86kkd/millionBoard/docs/guide/hardware/Longboard - rev - 07 - 04.JPG

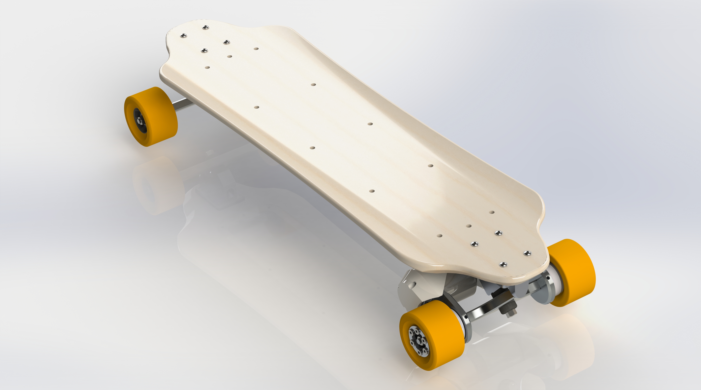
docs/guide/hardware/Longboard - rev - 07 - 04.JPG
