86kkd/millionBoard/docs/guide/hardware/第一版3.png

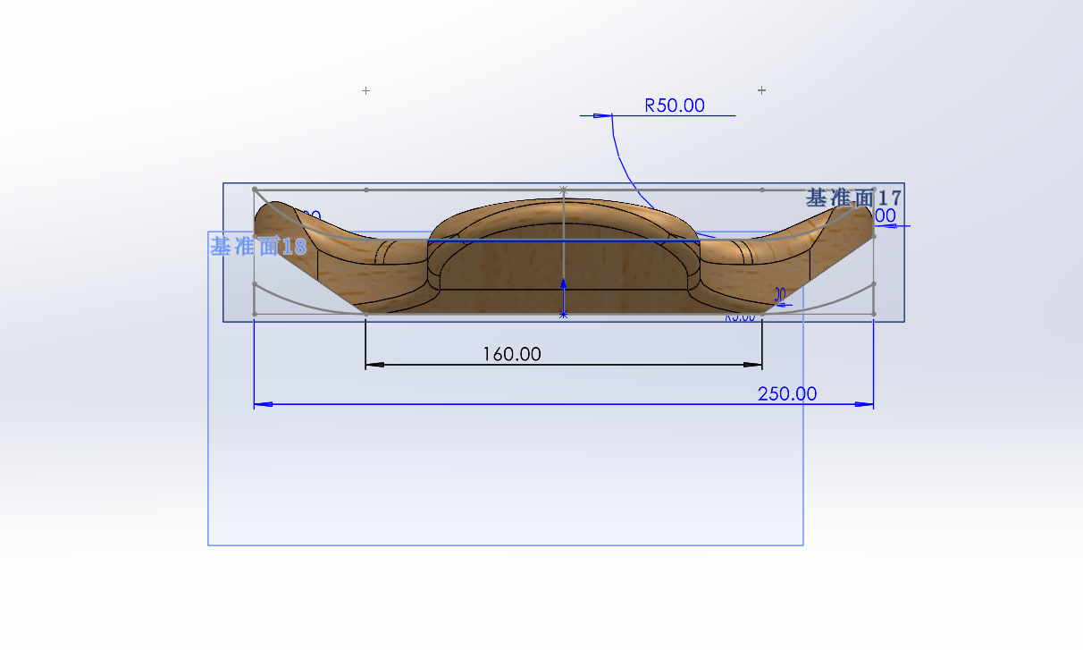
docs/guide/hardware/第一版3.png
