86kkd/millionBoard/README.md

# TODO list

- [x] 电源输入端大电容

- [x] 功率线宽度足够

- [x] 搞懂6pwm和3pwm控制的区别

- [ ] 模拟电路-数字电路去耦合
