86kkd/millionBoard/docs/guide/firmware/SCH_Schematic1_1-电池保护电路_2024-09-30.png

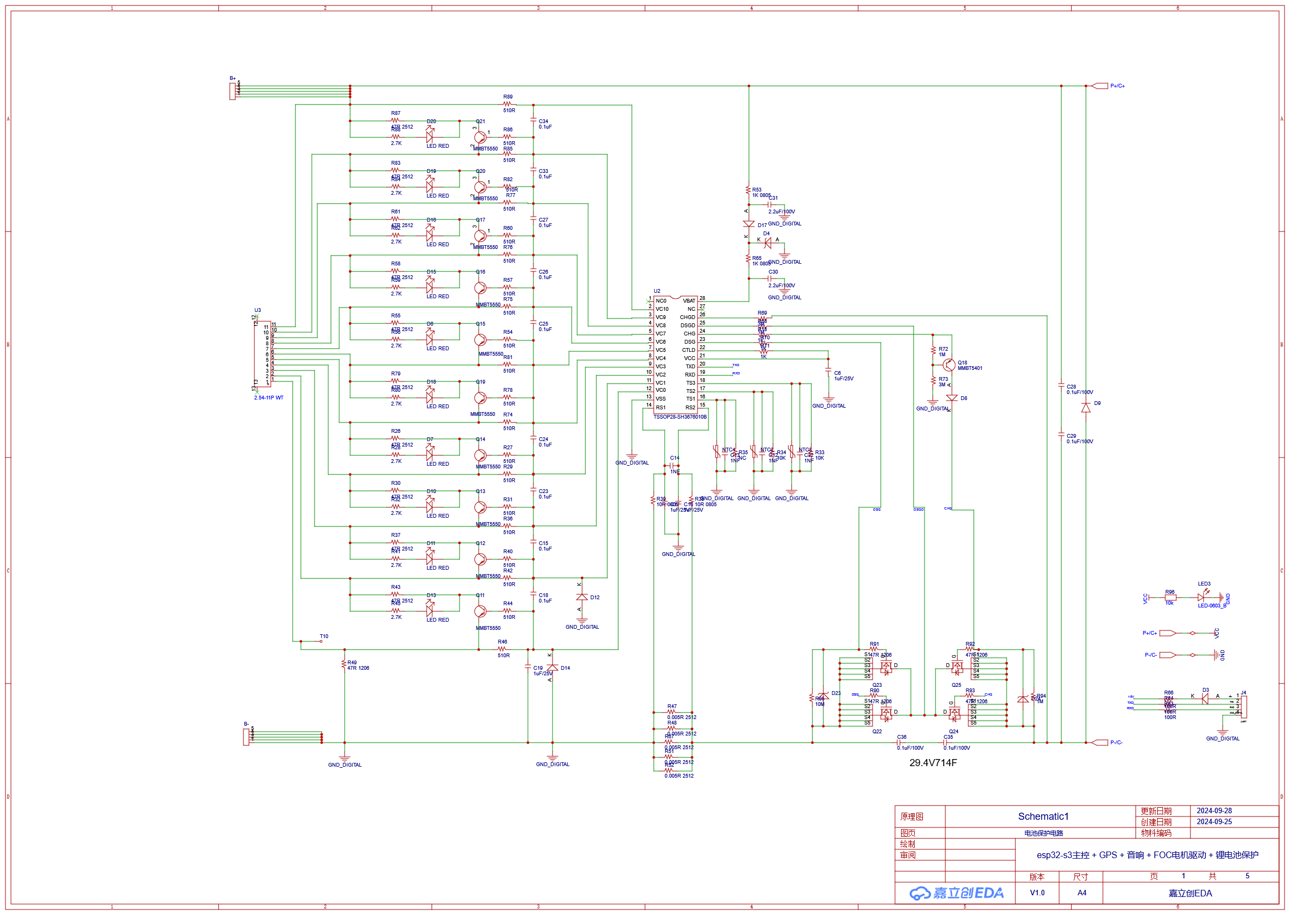
docs/guide/firmware/SCH_Schematic1_1-电池保护电路_2024-09-30.png
