86kkd/millionBoard/docs/guide/firmware/SCH_Schematic1_2-FOC驱动电路_2024-09-30.png

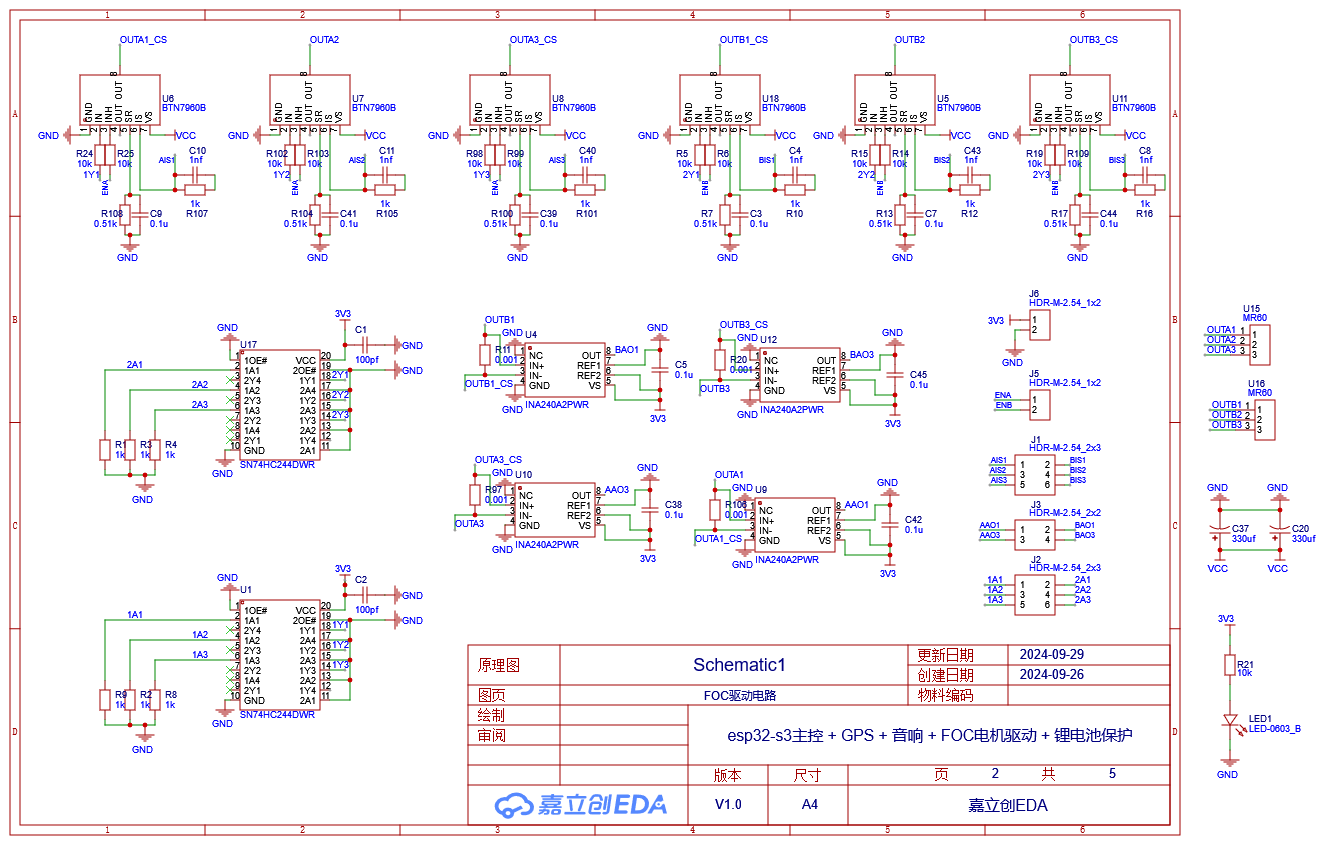
docs/guide/firmware/SCH_Schematic1_2-FOC驱动电路_2024-09-30.png
