86kkd/millionBoard/docs/guide/firmware/SCH_Schematic1_3-CAN AD和DC-DC_2024-09-30.png

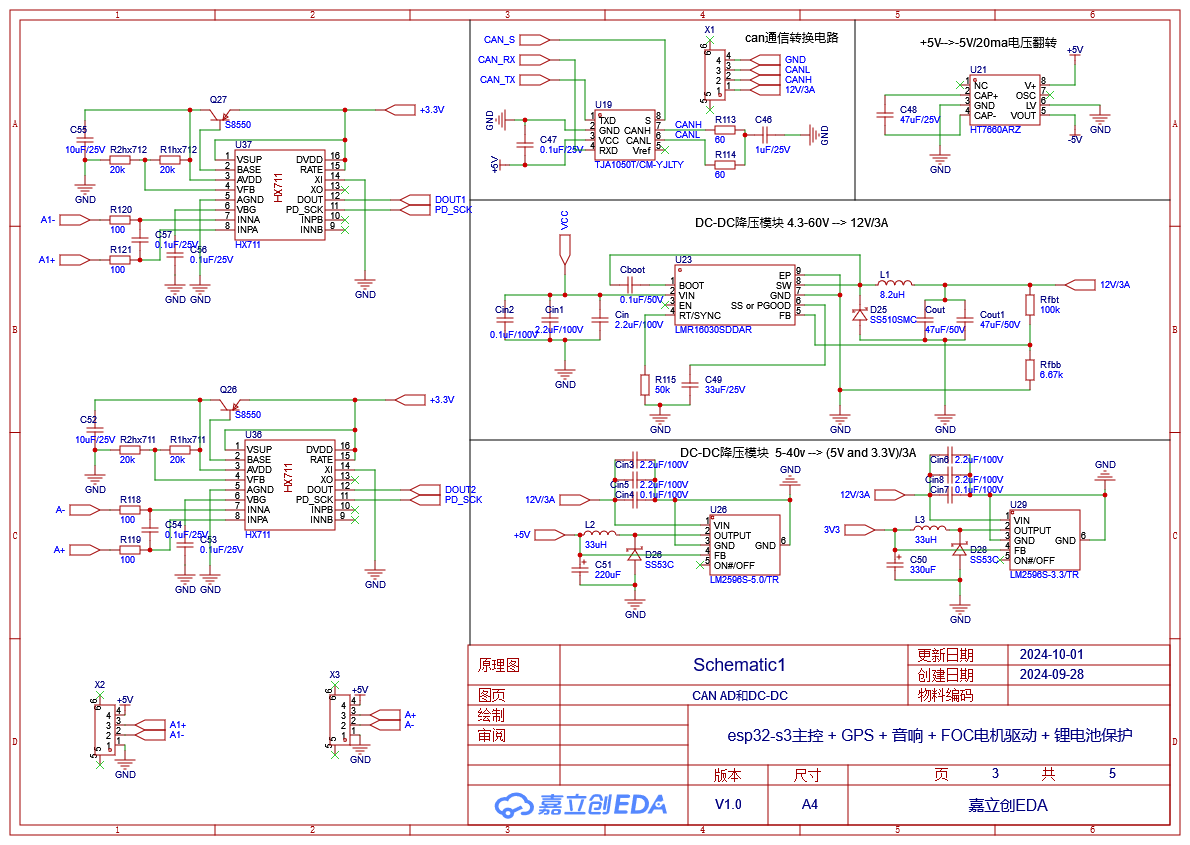
docs/guide/firmware/SCH_Schematic1_3-CAN AD和DC-DC_2024-09-30.png
