86kkd/millionBoard/docs/guide/firmware/SCH_Schematic1_4-GPS和音响_2024-09-30.png

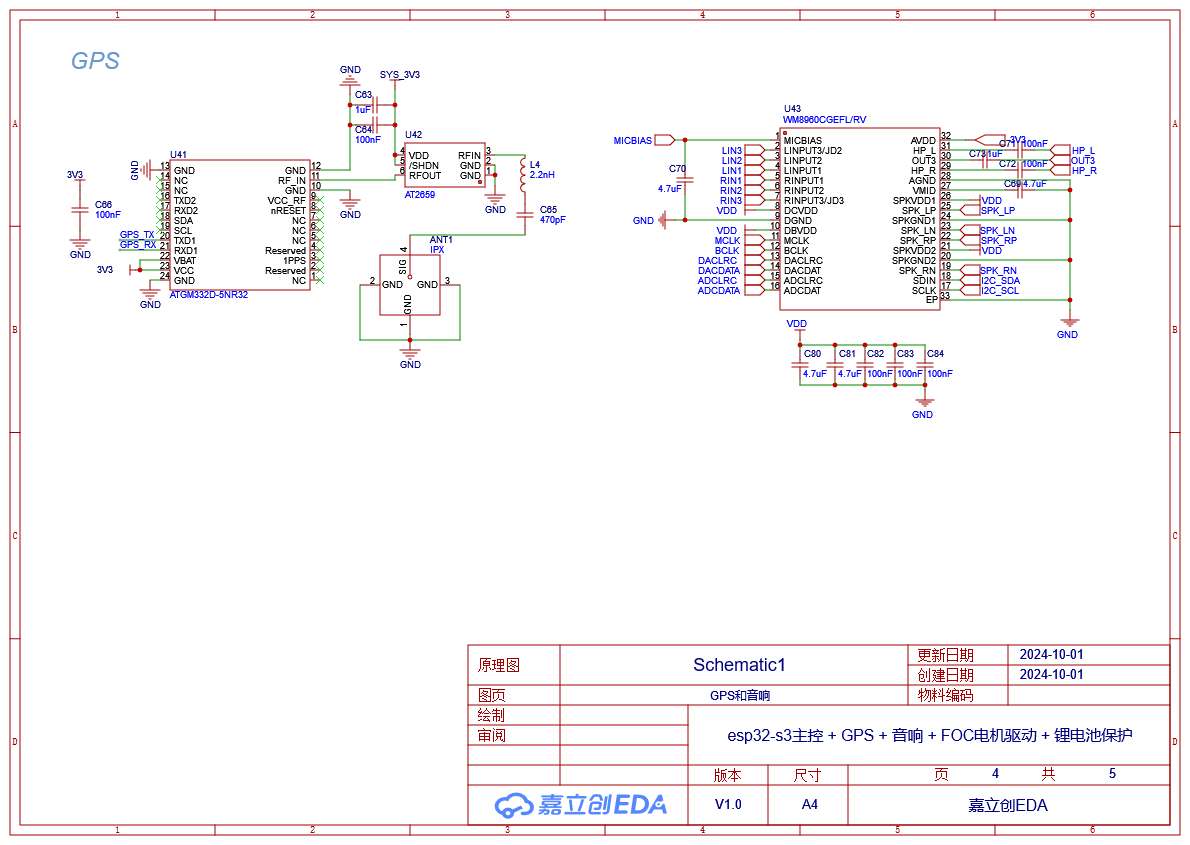
docs/guide/firmware/SCH_Schematic1_4-GPS和音响_2024-09-30.png
