86kkd/millionBoard/docs/guide/firmware/SCH_Schematic1_5-esp32主控_2024-09-30.png

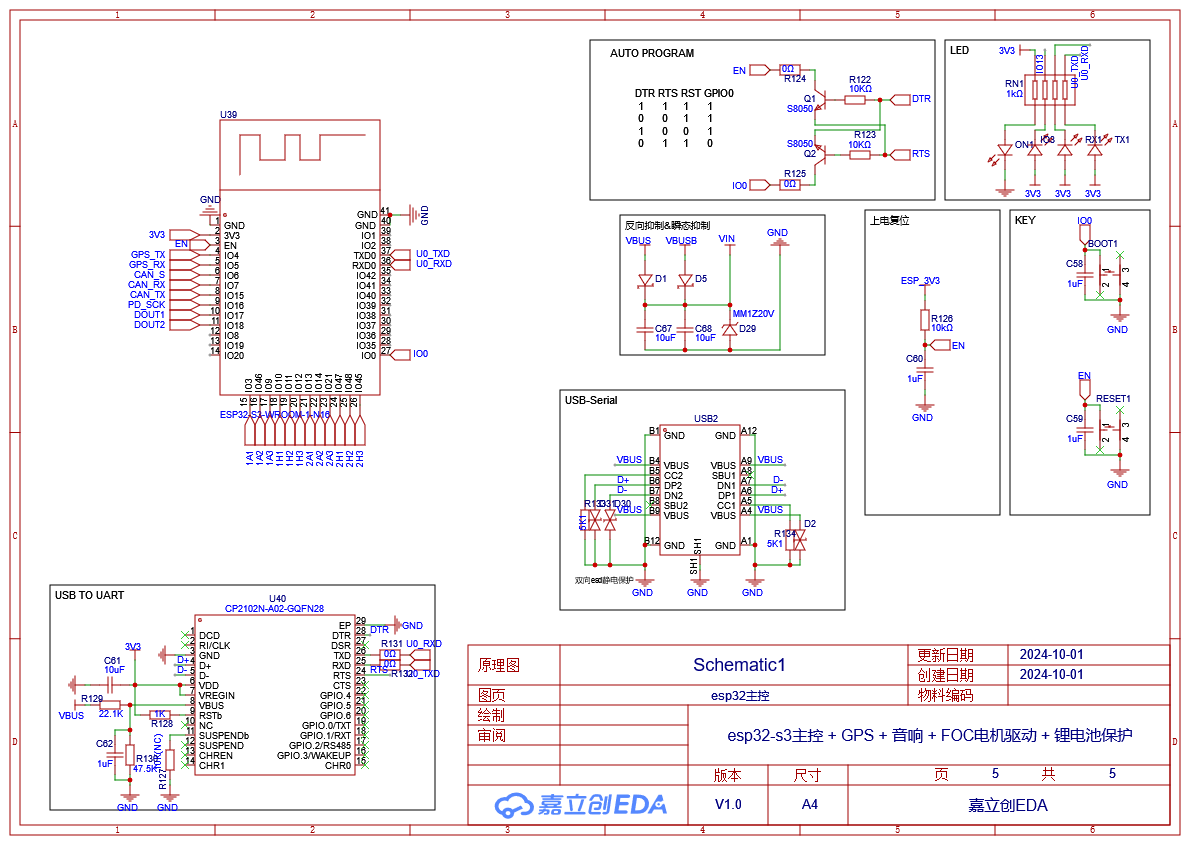
docs/guide/firmware/SCH_Schematic1_5-esp32主控_2024-09-30.png
