86kkd/millionBoard/docs/guide/hardware/IMG_20241001_045523.jpg

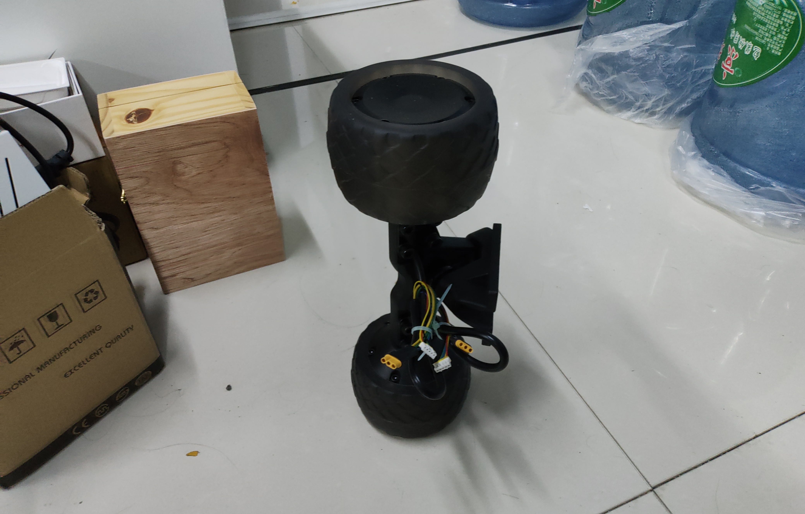
docs/guide/hardware/IMG_20241001_045523.jpg
