86kkd/millionBoard/docs/guide/hardware/IMG_20241001_051308.jpg

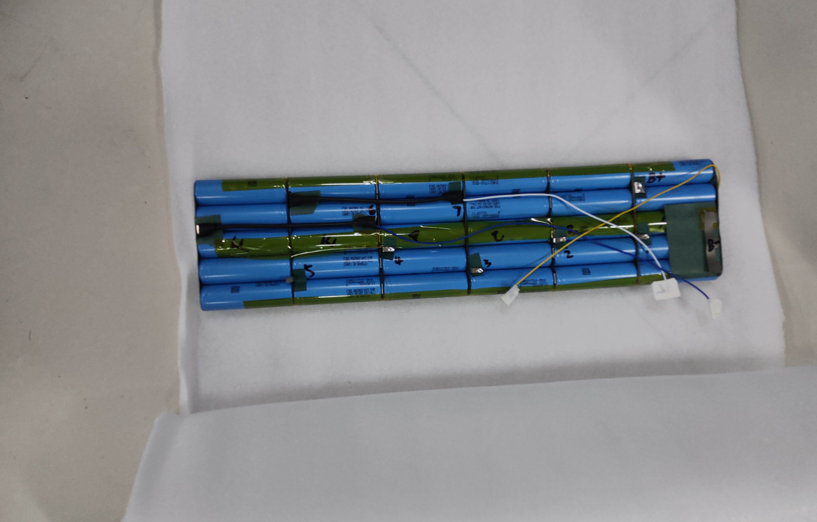
docs/guide/hardware/IMG_20241001_051308.jpg
