86kkd/millionBoard/docs/guide/hardware/Longboard - rev - 07 - 01.JPG

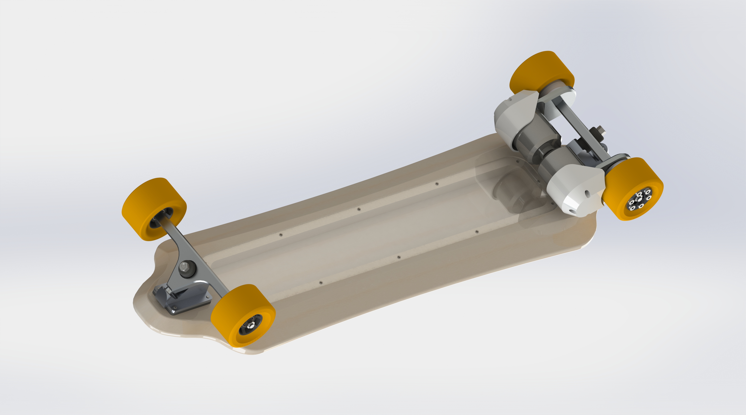
docs/guide/hardware/Longboard - rev - 07 - 01.JPG
