86kkd/millionBoard/docs/guide/hardware/Longboard - rev - 07 - 02.JPG

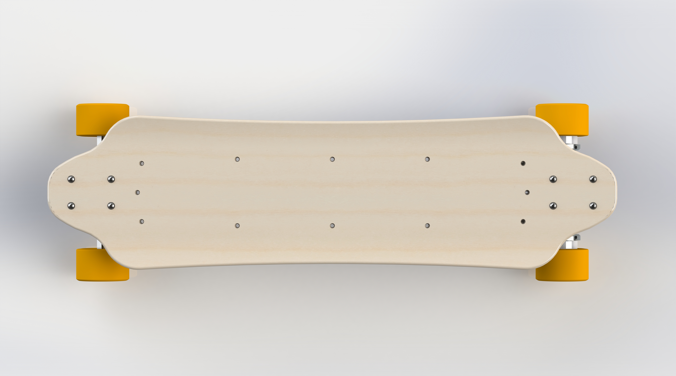
docs/guide/hardware/Longboard - rev - 07 - 02.JPG
