86kkd/millionBoard/docs/guide/hardware/Longboard - rev - 07 - 03.JPG

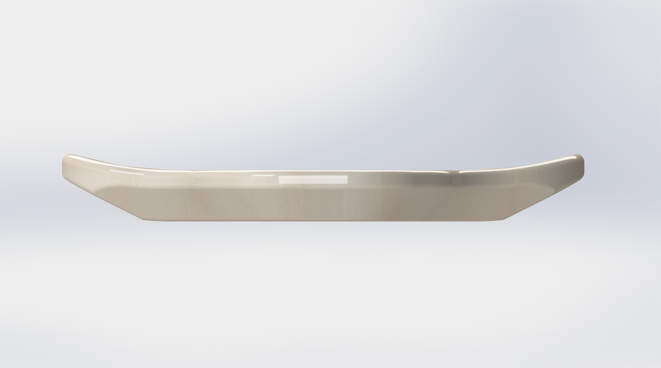
docs/guide/hardware/Longboard - rev - 07 - 03.JPG
