86kkd/millionBoard/docs/guide/hardware/Longboard - rev - 07 - 05.JPG

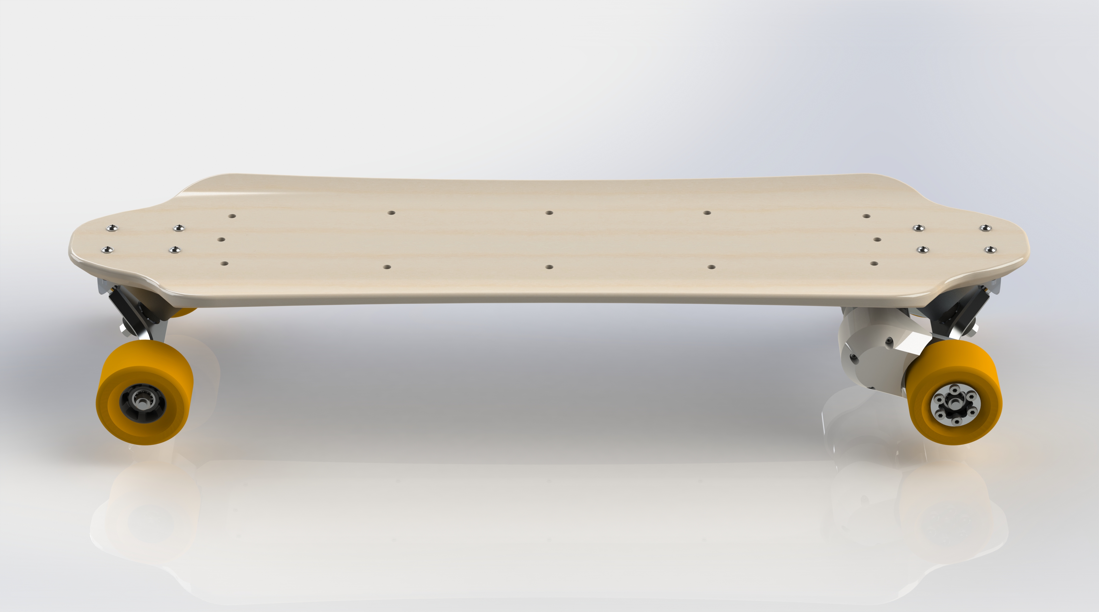
docs/guide/hardware/Longboard - rev - 07 - 05.JPG
