86kkd/millionBoard/docs/guide/hardware/滑板2.png

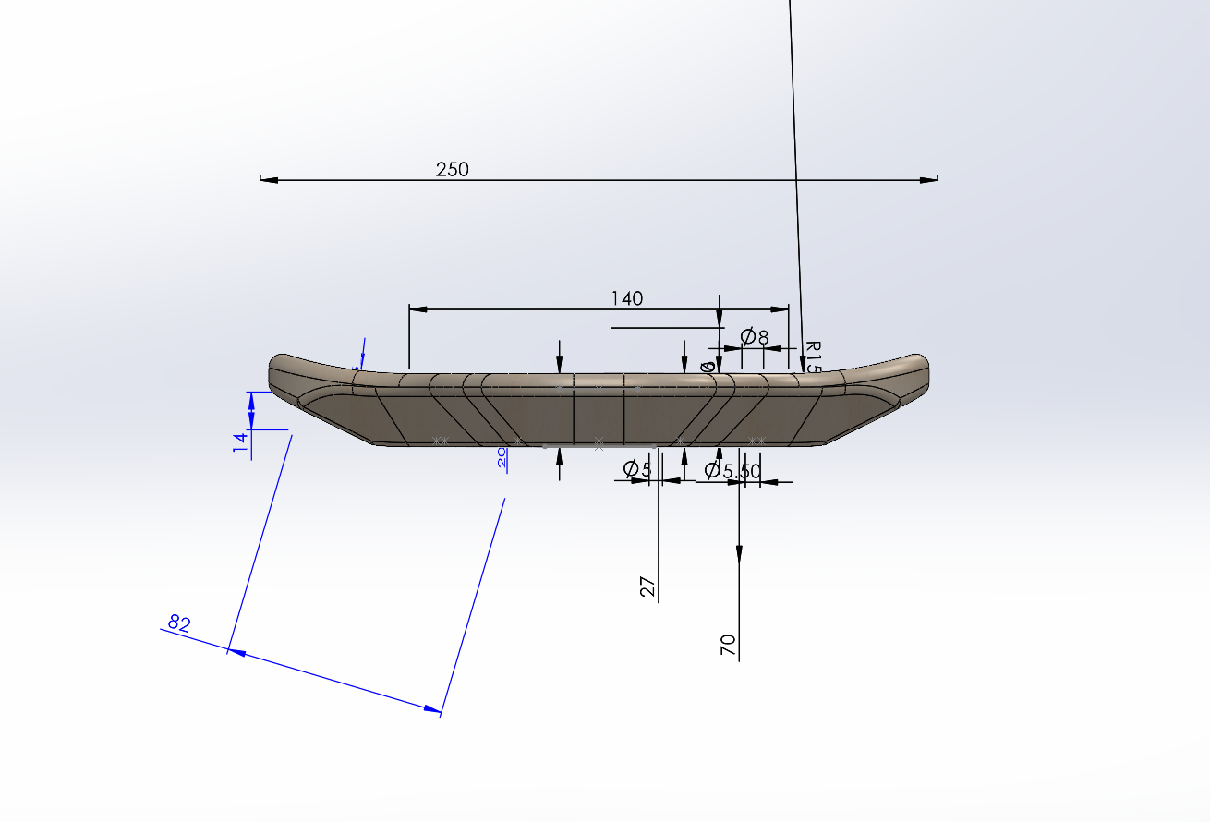
docs/guide/hardware/滑板2.png
