86kkd/millionBoard/docs/guide/hardware/滑板3.png

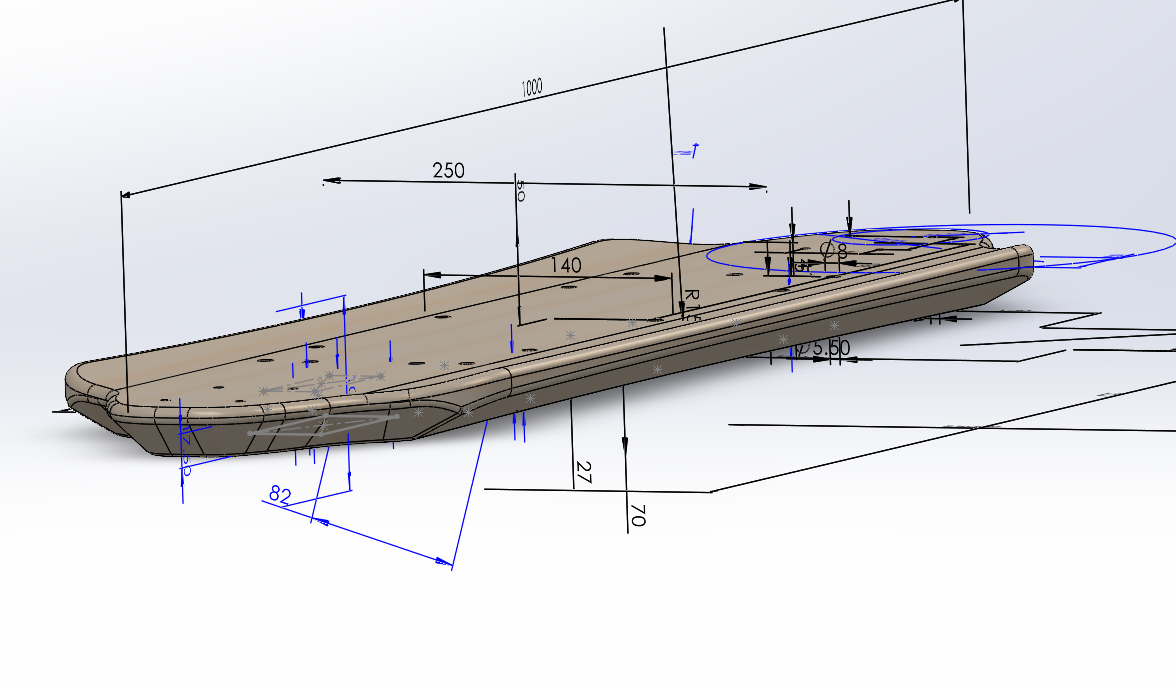
docs/guide/hardware/滑板3.png
