86kkd/millionBoard/docs/guide/hardware/滑板.png

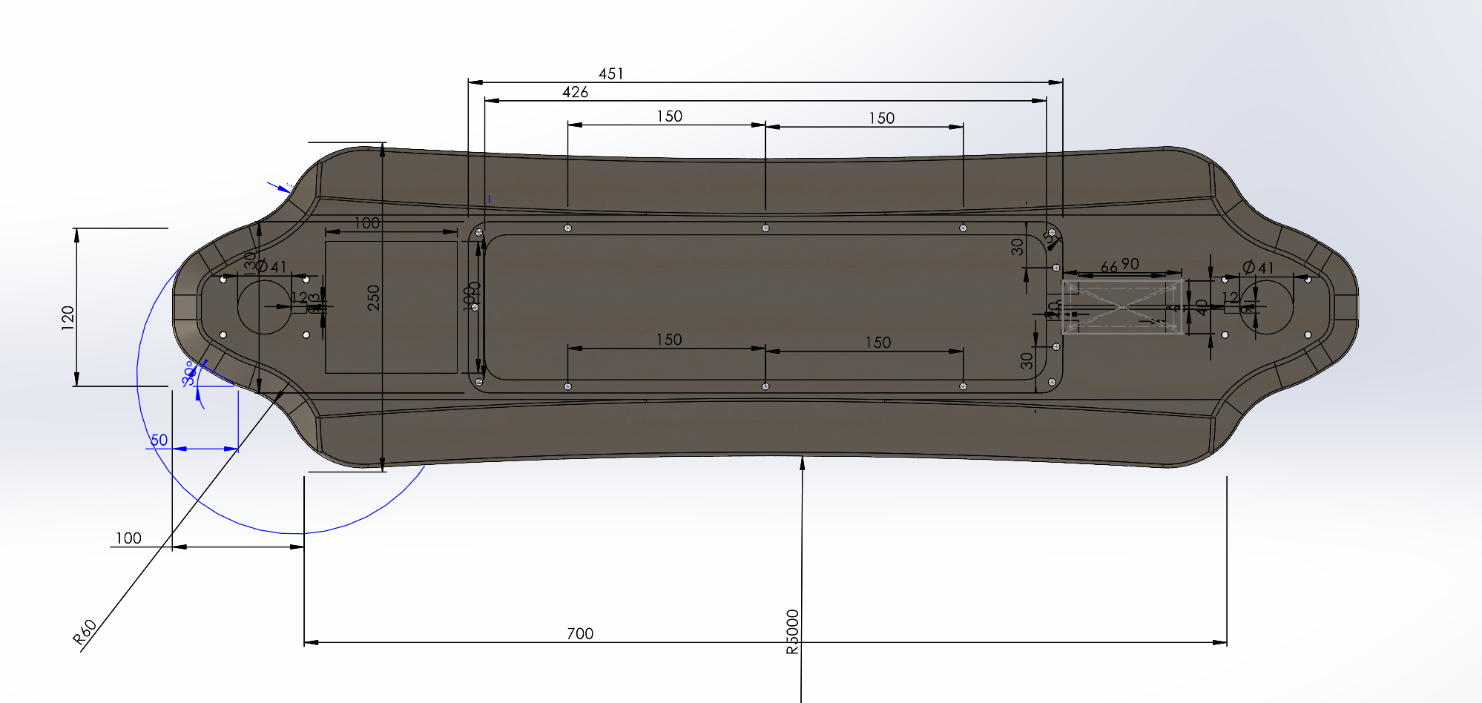
docs/guide/hardware/滑板.png
