86kkd/millionBoard/docs/guide/hardware/滑板本体.png

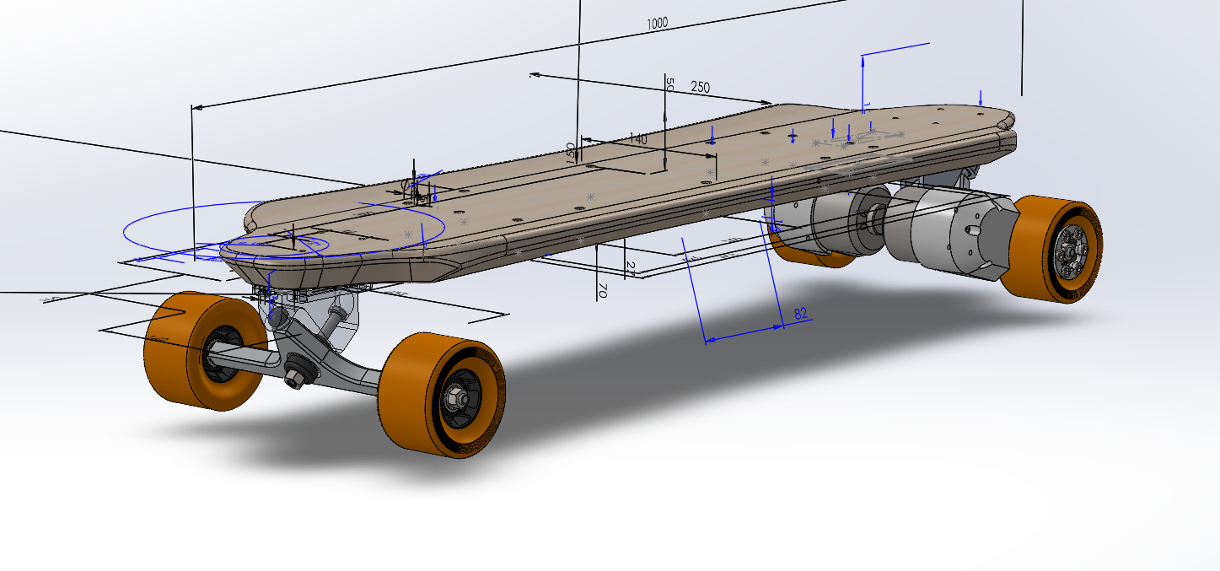
docs/guide/hardware/滑板本体.png
