86kkd/millionBoard/docs/guide/hardware/第一版2.png

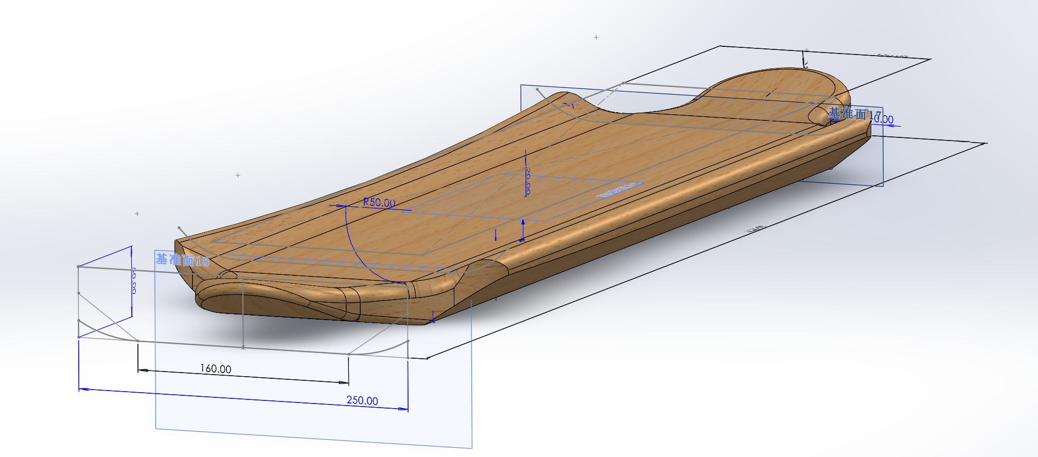
docs/guide/hardware/第一版2.png
