86kkd/millionBoard/docs/guide/hardware/第一版.png

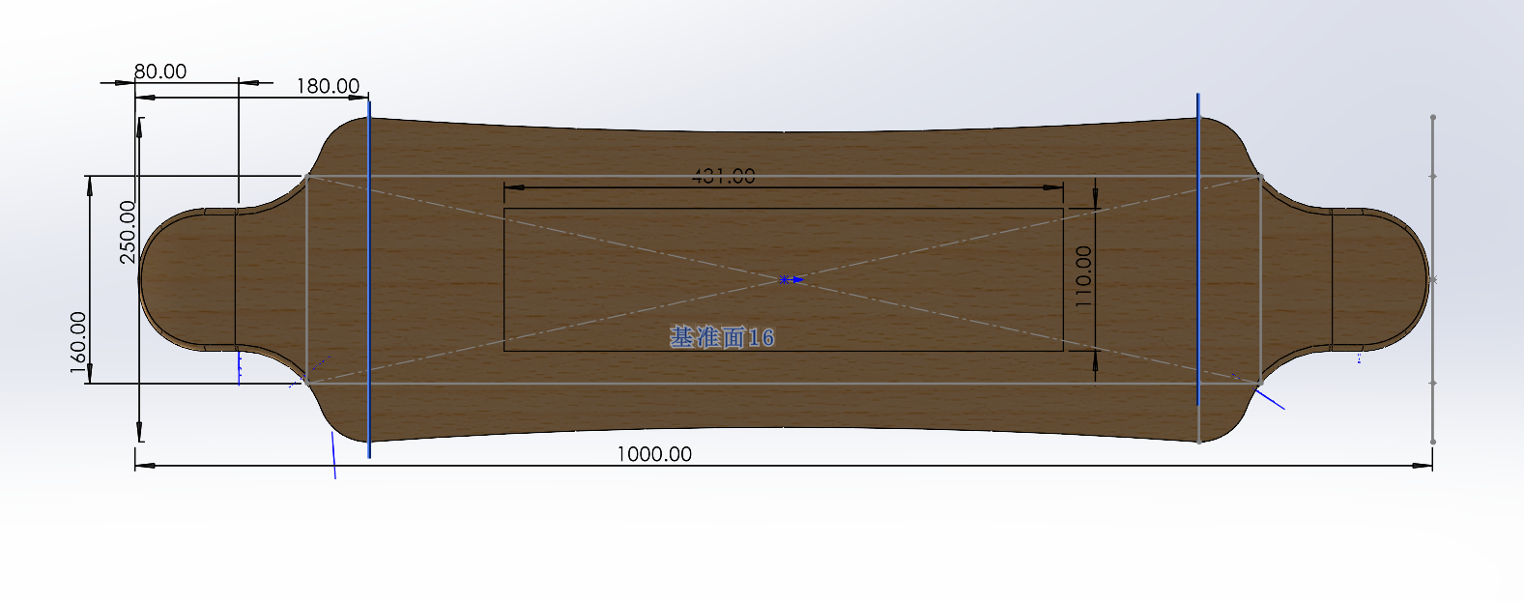
docs/guide/hardware/第一版.png
