86kkd/millionBoard/pcb/battery/battery.png

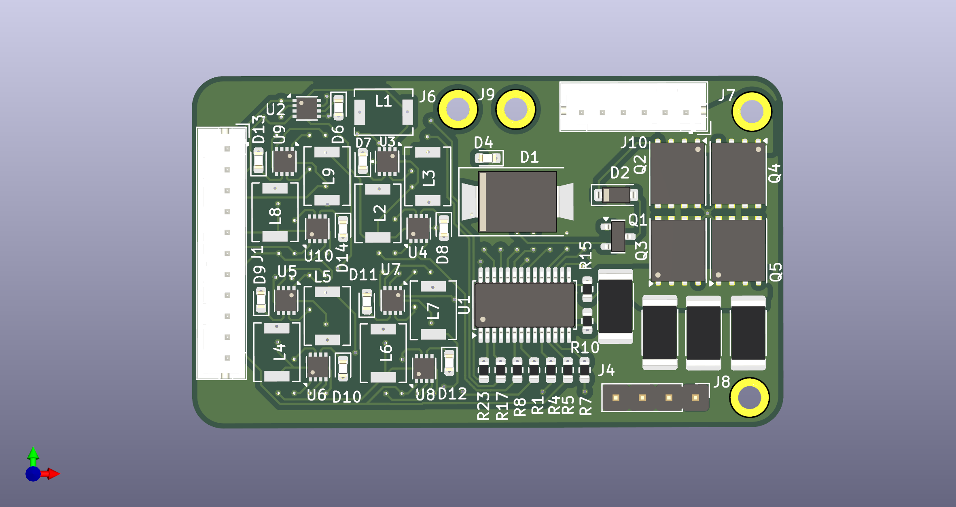
pcb/battery/battery.png
