86kkd/millionBoard/solidwork/电池.SLDASM

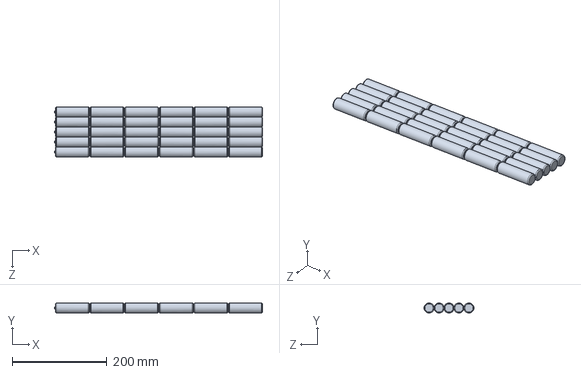
[picture p23: CAD file, 2024-09-26]
solidwork/电池.SLDASM
438.3 x 21.0 x 105.0 mm
电池零件 x 30
