86kkd/millionBoard/solidwork/3D model/Truck.SLDASM

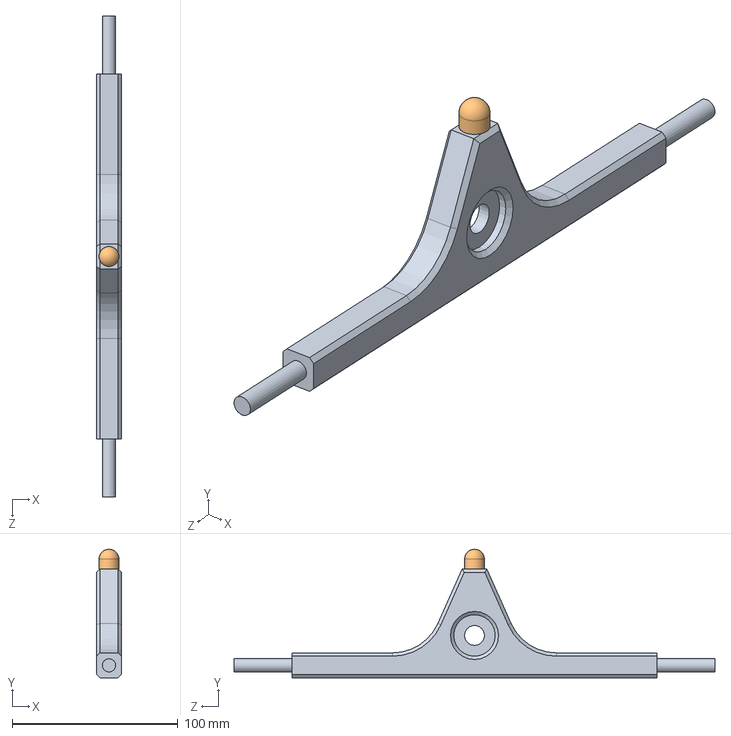
[picture p24: CAD file, 2024-09-26]
solidwork/3D model/Truck.SLDASM
15.0 x 77.5 x 290.0 mm
Truck_shaft
Truck_nail
