86kkd/millionBoard/solidwork/3D model/Wheel_pulley.SLDASM

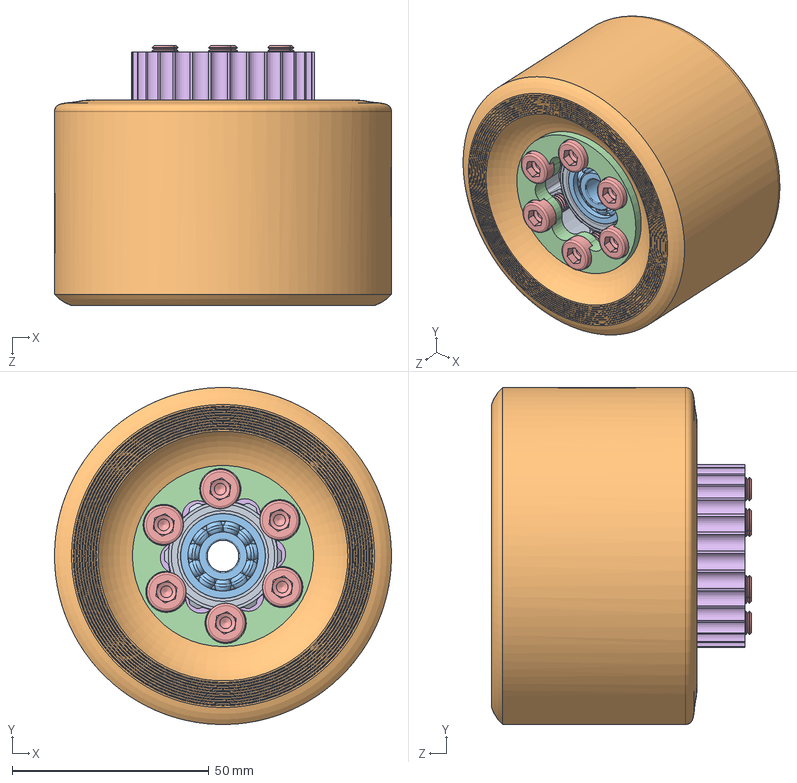
[picture p25: CAD file, 2024-09-26]
solidwork/3D model/Wheel_pulley.SLDASM
85.6 x 85.6 x 66.1 mm
Wheel-base-abec
Wheel-rubber-abec
radial ball bearing_68_din x 2
Ring_belt_drive
socket thin pilot cap screw_din x 6
HTD - 5M - 30T - pulley
