86kkd/millionBoard/solidwork/3D model/Truck_drive.SLDASM

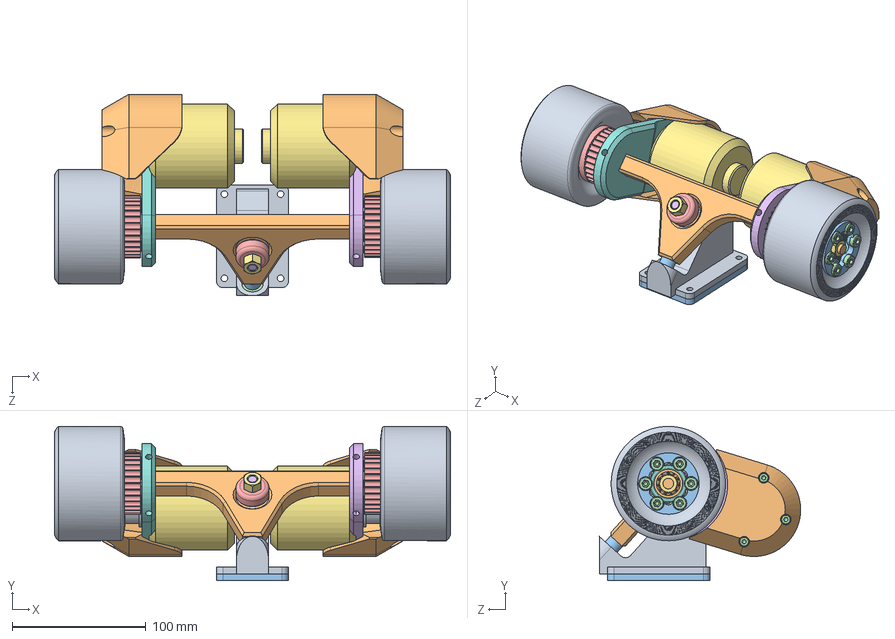
[picture p26: CAD file, 2024-09-26]
solidwork/3D model/Truck_drive.SLDASM
296.4 x 115.4 x 150.7 mm
Truck_base
Truck_shaft
Truck_nail
Rubber-truck-holder
Rubber_truck_holder_2 x 2
Trucks-main-bolt
hex nut gradec_din x 3
Wheel-base-abec x 2
Wheel-rubber-abec x 2
radial ball bearing_68_din x 4
Ring_belt_drive x 2
socket thin pilot cap screw_din x 12
HTD - 5M - 30T - pulley x 2
Motor-mount-left
Motor x 2
Motor-mount-right
Pulley_HDT_5M_15T x 2
Belt-protector x 2
Truck_base_rubber
socket head cap screw_din x 6
Pulley_wedge x 2
