86kkd/millionBoard/solidwork/3D model/Wheel-real.SLDASM

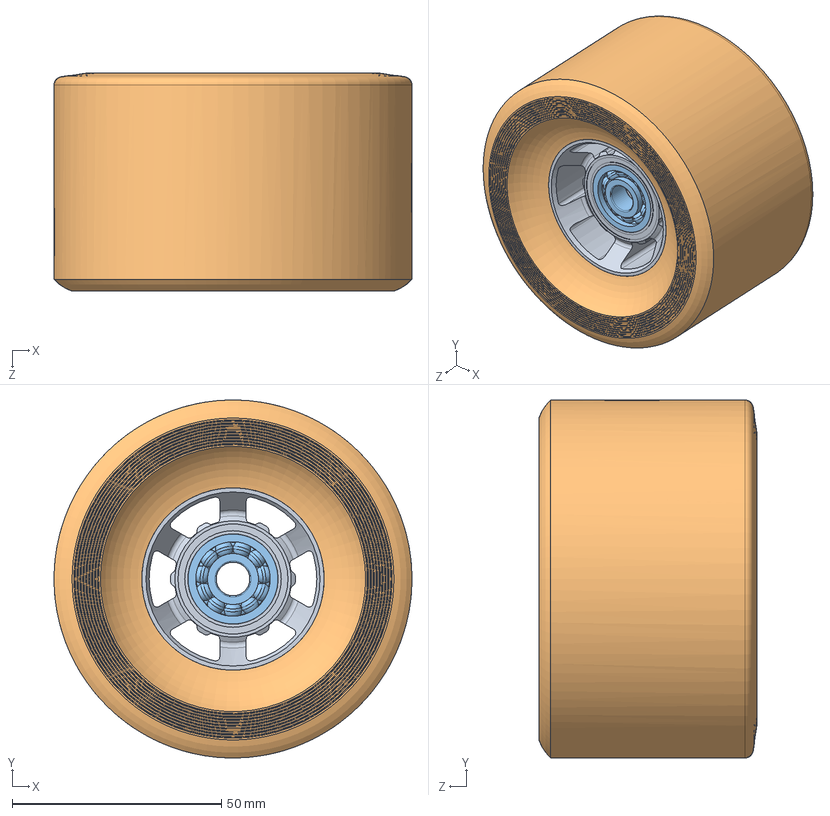
[picture p27: CAD file, 2024-09-26]
solidwork/3D model/Wheel-real.SLDASM
85.6 x 85.6 x 52.2 mm
Wheel-base-abec
Wheel-rubber-abec
radial ball bearing_68_din x 2
