86kkd/millionBoard/solidwork/3D model/Truck_front.SLDASM

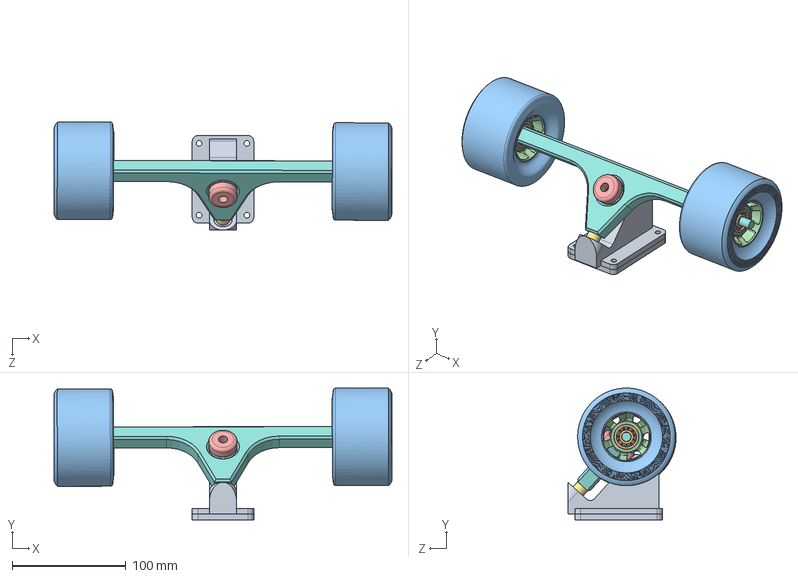
[picture p28: CAD file, 2024-09-26]
solidwork/3D model/Truck_front.SLDASM
296.7 x 115.7 x 94.9 mm
Truck_base
Truck_shaft
Truck_nail
Rubber-truck-holder
Rubber_truck_holder_2 x 2
Wheel-base-abec x 2
Wheel-rubber-abec x 2
radial ball bearing_68_din x 4
Truck_base_rubber
