86kkd/millionBoard/solidwork/3D model/Longboard.SLDASM

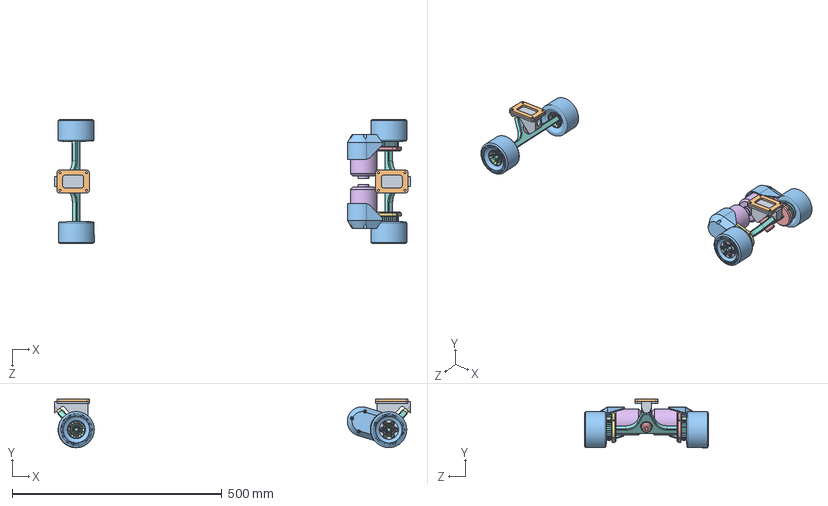
[picture p29: CAD file, 2024-09-26]
solidwork/3D model/Longboard.SLDASM
849.0 x 115.7 x 296.7 mm
Truck_base x 2
Truck_shaft x 2
Truck_nail x 2
Rubber-truck-holder x 2
Rubber_truck_holder_2 x 4
Wheel-base-abec x 4
Wheel-rubber-abec x 4
radial ball bearing_68_din x 8
Ring_belt_drive x 2
HTD - 5M - 30T - pulley x 2
Motor-mount-left
Motor x 2
Motor-mount-right
Pulley_HDT_5M_15T x 2
Belt-protector x 2
Truck_base_rubber x 2
Pulley_wedge x 2
