86kkd/millionBoard/solidwork/3D model/Wheel-base-abec.SLDPRT

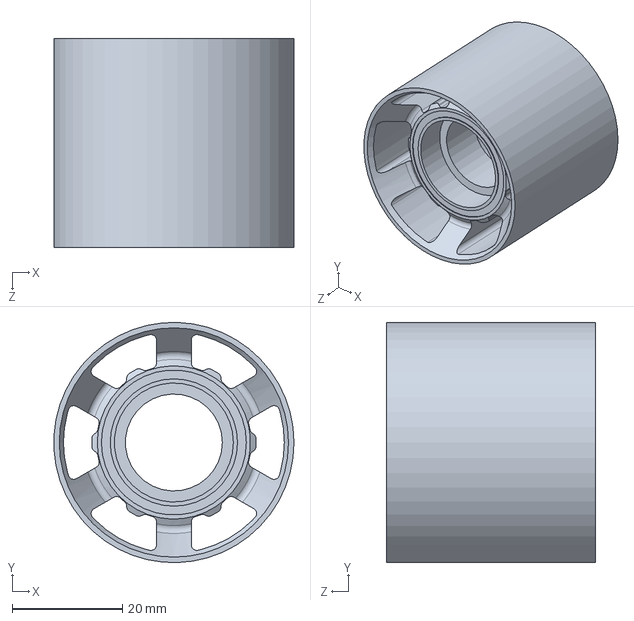
[picture p30: CAD file, 2024-09-26]
solidwork/3D model/Wheel-base-abec.SLDPRT
43.6 x 43.6 x 38.0 mm
