86kkd/millionBoard/solidwork/Deck.STEP

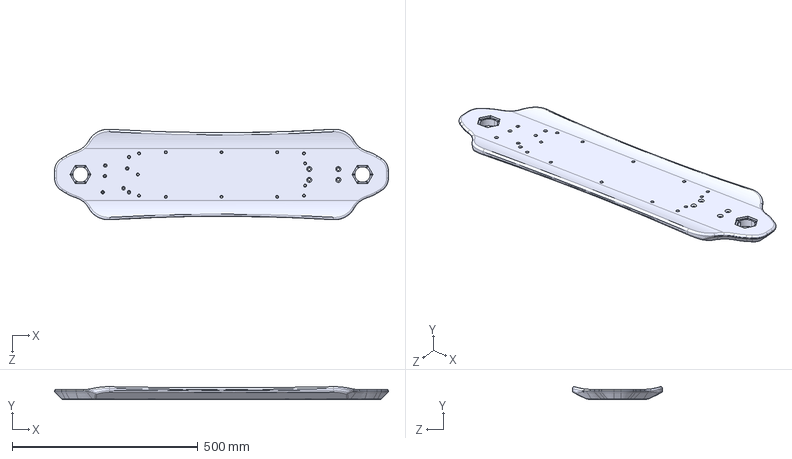
[picture p31: CAD file, 2025-04-06]
solidwork/Deck.STEP
900.0 x 34.3 x 243.8 mm
