86kkd/millionBoard/solidwork/Electronics enclosure.STEP

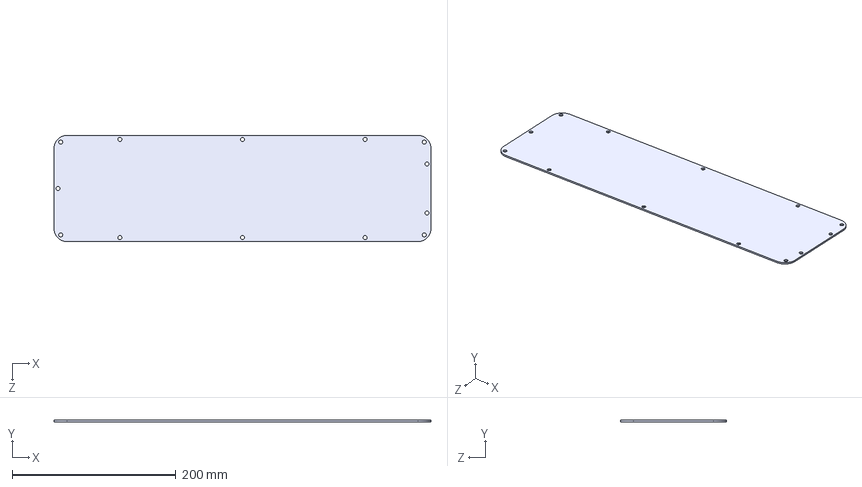
[picture p32: CAD file, 2025-04-06]
solidwork/Electronics enclosure.STEP
461.0 x 2.00 x 130.0 mm
