86kkd/millionBoard/solidwork/3D model/Rubber_truck_holder_2.SLDPRT

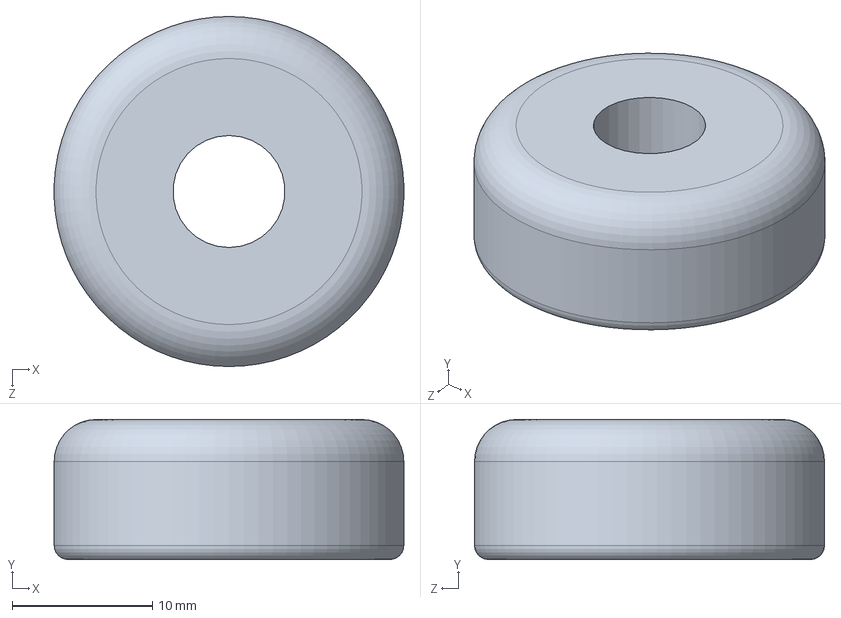
[picture p33: CAD file, 2024-09-26]
solidwork/3D model/Rubber_truck_holder_2.SLDPRT
25.0 x 10.0 x 25.0 mm
