86kkd/millionBoard/solidwork/主板保护.STEP

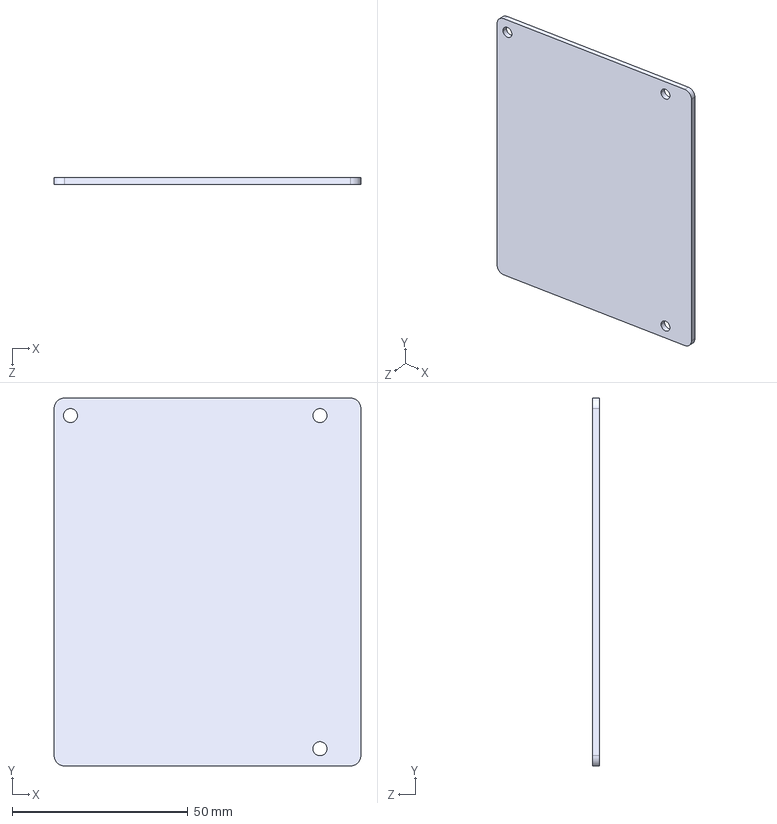
[picture p34: CAD file, 2025-04-06]
solidwork/主板保护.STEP
87.3 x 104.7 x 2.00 mm
