86kkd/millionBoard/solidwork/3D model/Truck_nail.SLDPRT

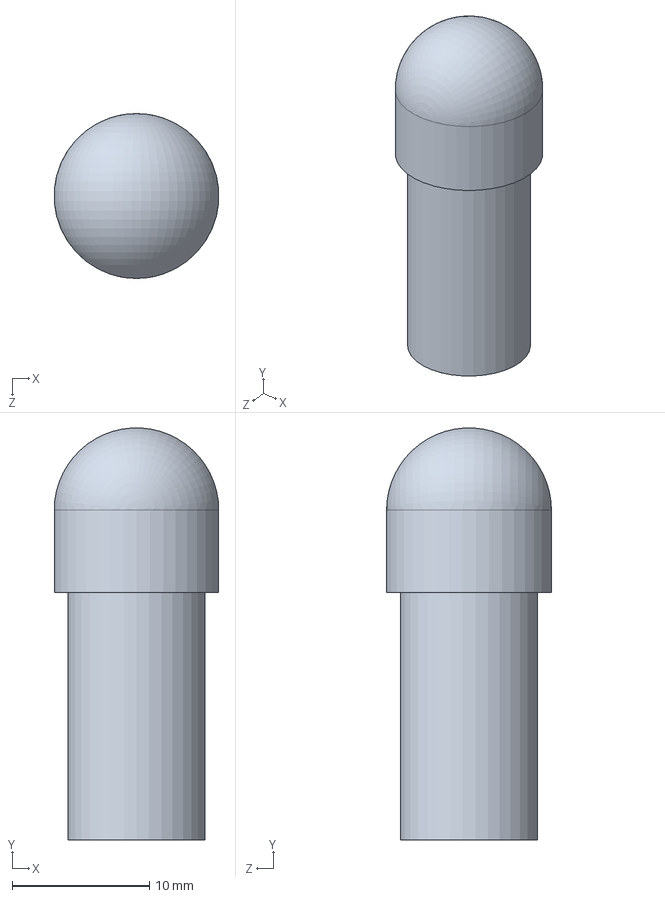
[picture p35: CAD file, 2024-09-26]
solidwork/3D model/Truck_nail.SLDPRT
12.0 x 30.0 x 12.0 mm
