86kkd/millionBoard/solidwork/3D model/Truck_base.SLDPRT

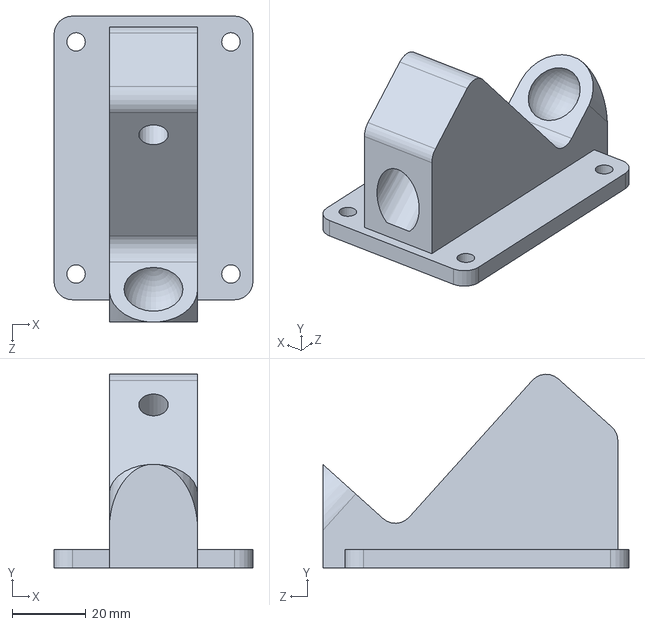
[picture p36: CAD file, 2024-09-26]
solidwork/3D model/Truck_base.SLDPRT
54.0 x 52.5 x 83.0 mm
