86kkd/millionBoard/solidwork/垫片-上.STEP

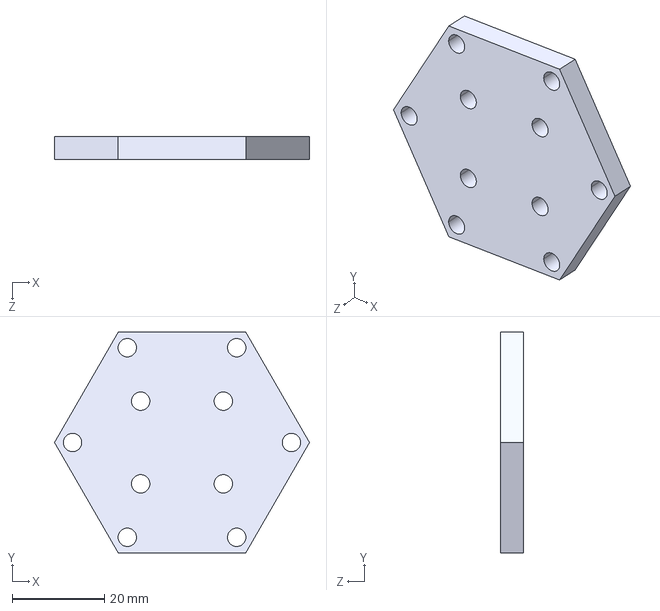
[picture p37: CAD file, 2025-03-27]
solidwork/垫片-上.STEP
55.4 x 48.0 x 5.00 mm
