86kkd/millionBoard/solidwork/3D model/板体.SLDPRT

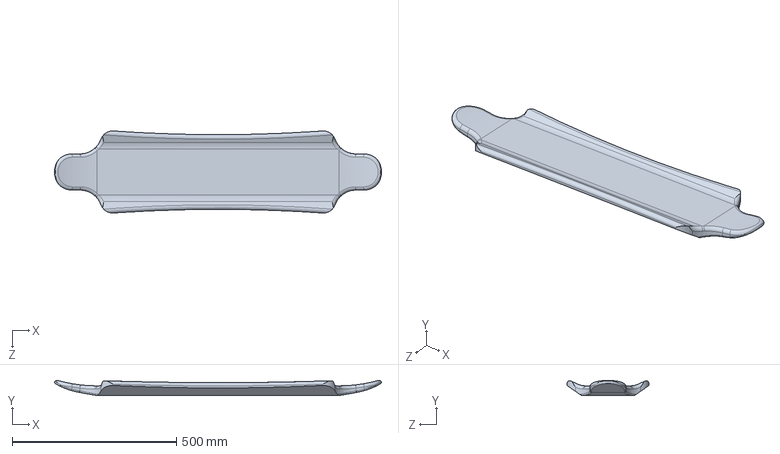
[picture p38: CAD file, 2024-09-26]
solidwork/3D model/板体.SLDPRT
995.2 x 46.6 x 250.0 mm
