86kkd/millionBoard/solidwork/垫片-下.STEP

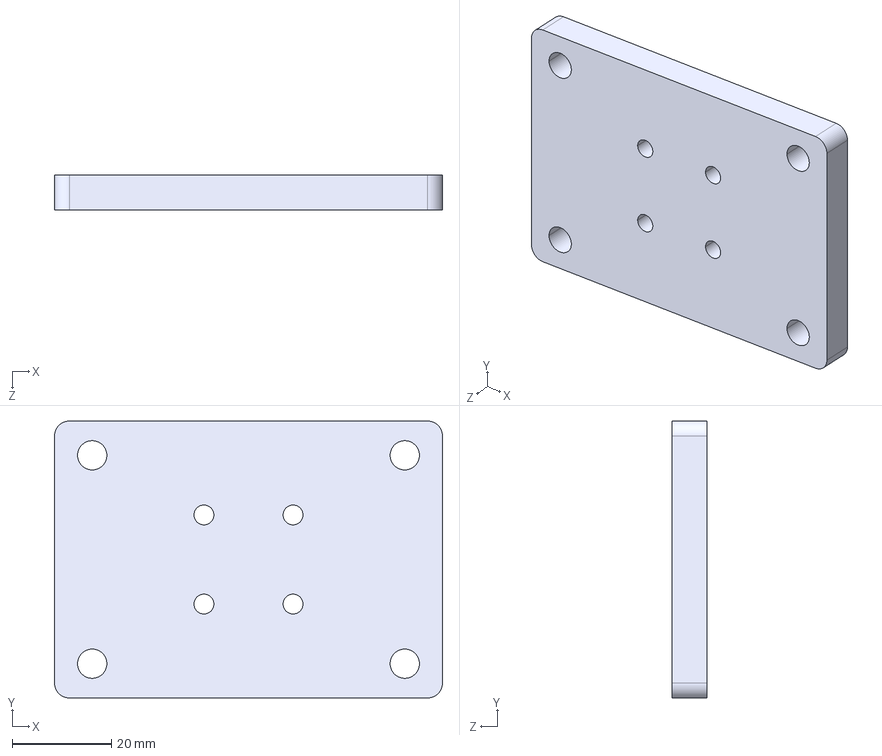
[picture p39: CAD file, 2025-03-27]
solidwork/垫片-下.STEP
78.2 x 55.8 x 7.00 mm
