86kkd/millionBoard/solidwork/电池零件.SLDPRT

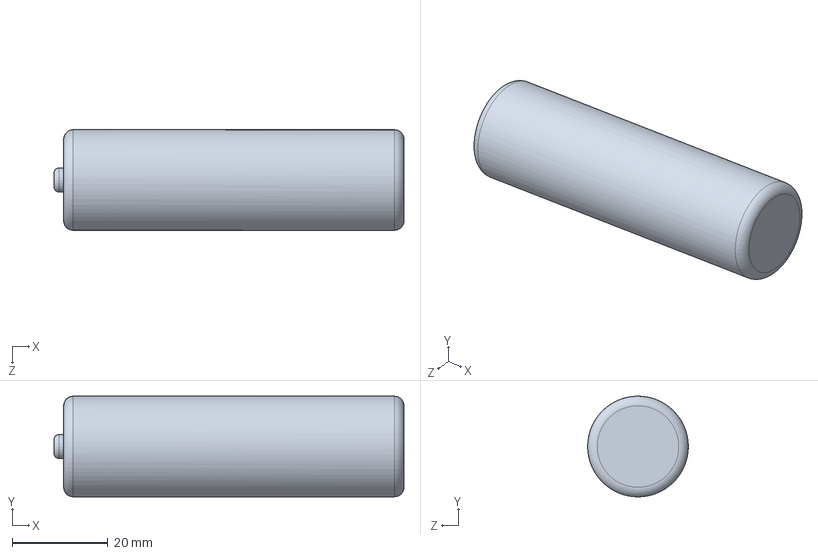
[picture p40: CAD file, 2024-09-26]
solidwork/电池零件.SLDPRT
73.0 x 21.0 x 21.0 mm
