86kkd/millionBoard/solidwork/零件1.SLDPRT

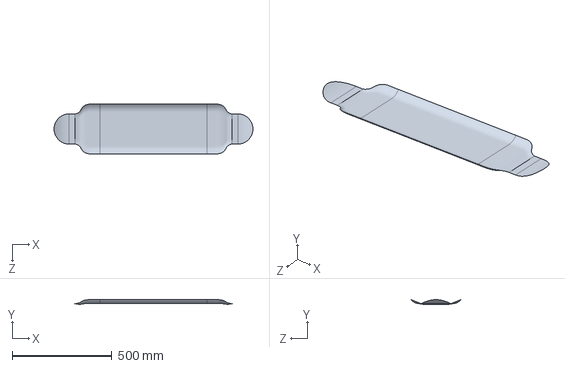
[picture p41: CAD file, 2024-09-26]
solidwork/零件1.SLDPRT
1000.0 x 23.9 x 250.0 mm
