86kkd/millionBoard/solidwork/3D model/Wheel-rubber-abec.SLDPRT

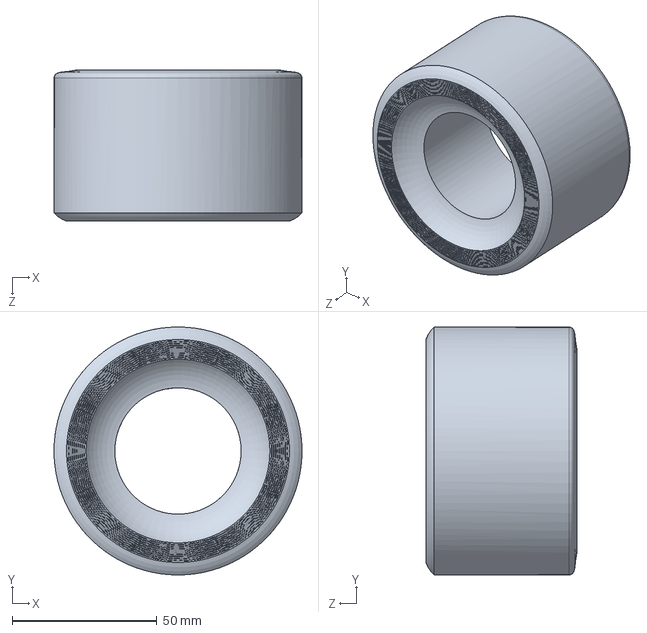
[picture p42: CAD file, 2024-09-26]
solidwork/3D model/Wheel-rubber-abec.SLDPRT
85.6 x 85.6 x 52.2 mm
