86kkd/millionBoard/solidwork/滑板.SLDPRT

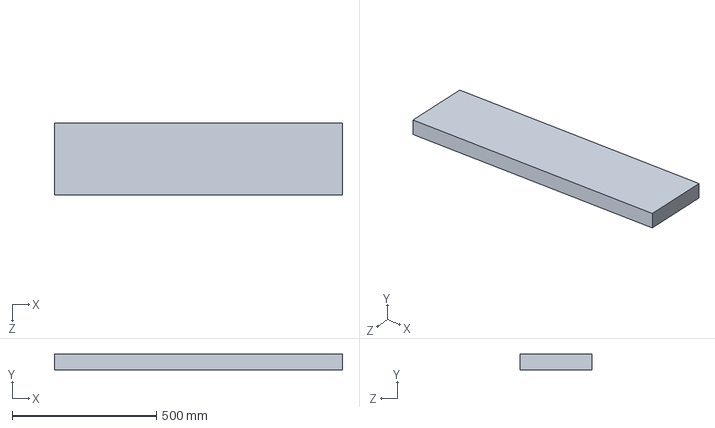
[picture p43: CAD file, 2024-09-26]
solidwork/滑板.SLDPRT
1000.0 x 55.0 x 250.0 mm
