86kkd/millionBoard/solidwork/3D model/Motor.SLDPRT

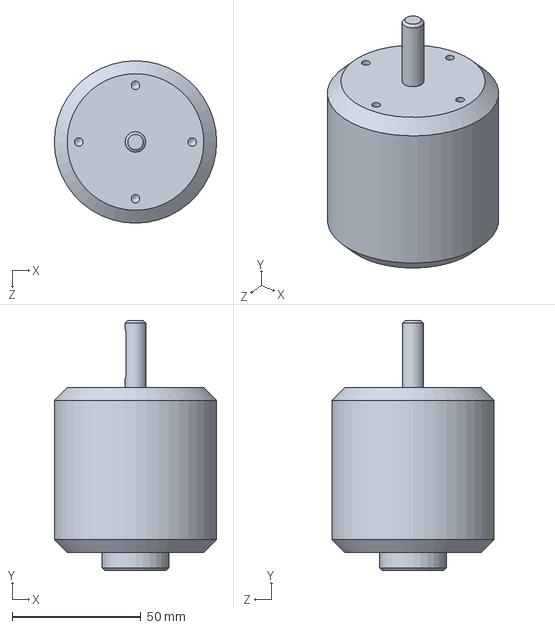
[picture p44: CAD file, 2024-09-26]
solidwork/3D model/Motor.SLDPRT
63.0 x 97.0 x 63.0 mm
