86kkd/millionBoard/solidwork/3D model/Truck_base_rubber.SLDPRT

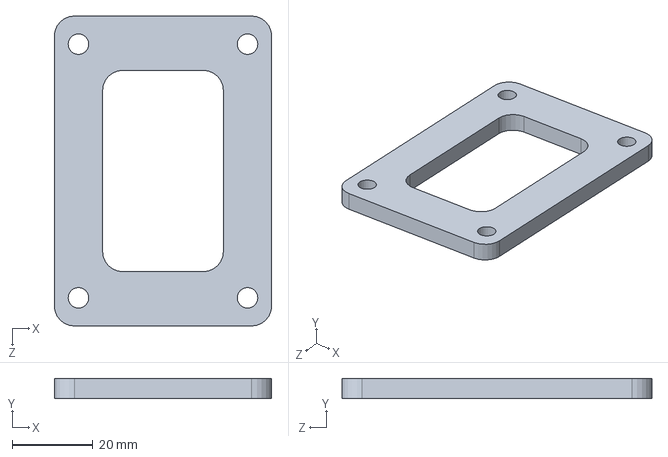
[picture p45: CAD file, 2024-09-26]
solidwork/3D model/Truck_base_rubber.SLDPRT
54.0 x 5.00 x 77.0 mm
