86kkd/millionBoard/solidwork/3D model/Ring_belt_drive.SLDPRT

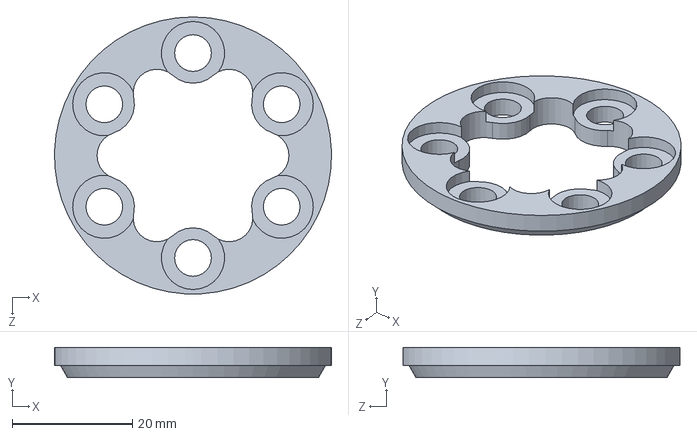
[picture p46: CAD file, 2024-09-26]
solidwork/3D model/Ring_belt_drive.SLDPRT
46.0 x 5.00 x 46.0 mm
