86kkd/millionBoard/solidwork/3D model/Pulley_wedge.SLDPRT

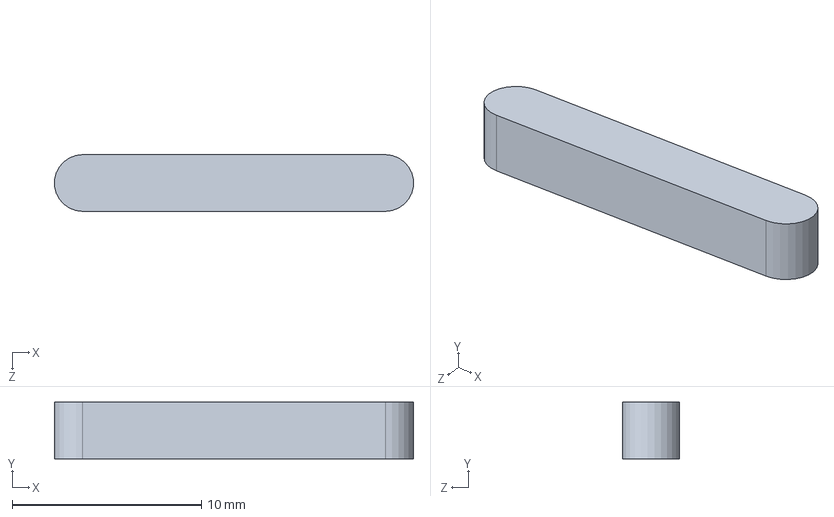
[picture p47: CAD file, 2024-09-26]
solidwork/3D model/Pulley_wedge.SLDPRT
19.0 x 3.00 x 3.00 mm
