86kkd/millionBoard/solidwork/3D model/Motor-mount-left.SLDPRT

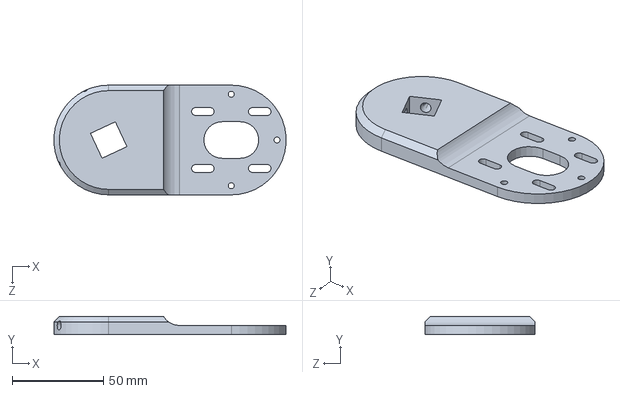
[picture p48: CAD file, 2024-09-26]
solidwork/3D model/Motor-mount-left.SLDPRT
126.8 x 10.0 x 60.0 mm
