86kkd/millionBoard/solidwork/3D model/陀螺仪.SLDPRT

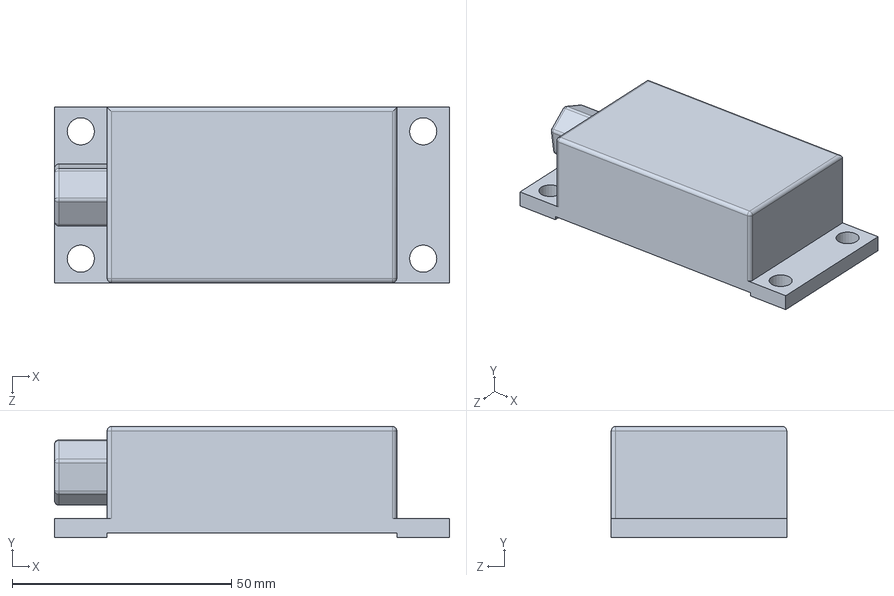
[picture p49: CAD file, 2024-09-26]
solidwork/3D model/陀螺仪.SLDPRT
90.0 x 25.3 x 40.0 mm
