86kkd/millionBoard/solidwork/3D model/Truck_shaft.SLDPRT

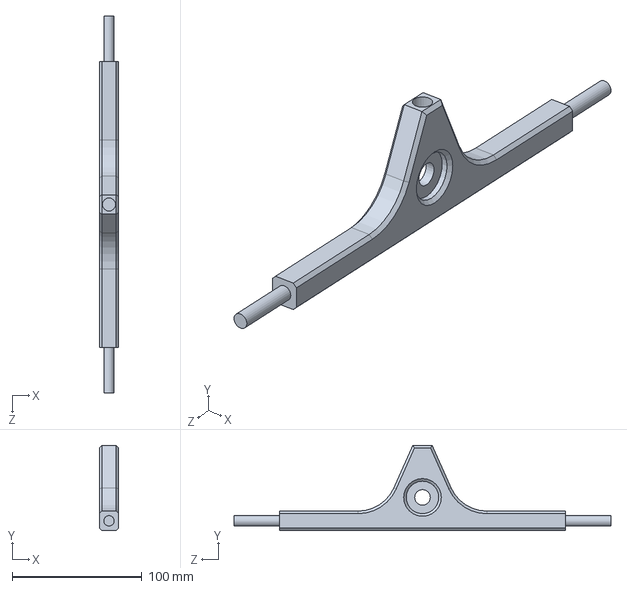
[picture p50: CAD file, 2024-09-26]
solidwork/3D model/Truck_shaft.SLDPRT
15.0 x 65.5 x 290.0 mm
