86kkd/millionBoard/solidwork/3D model/HTD - 5M - 30T - pulley.SLDPRT

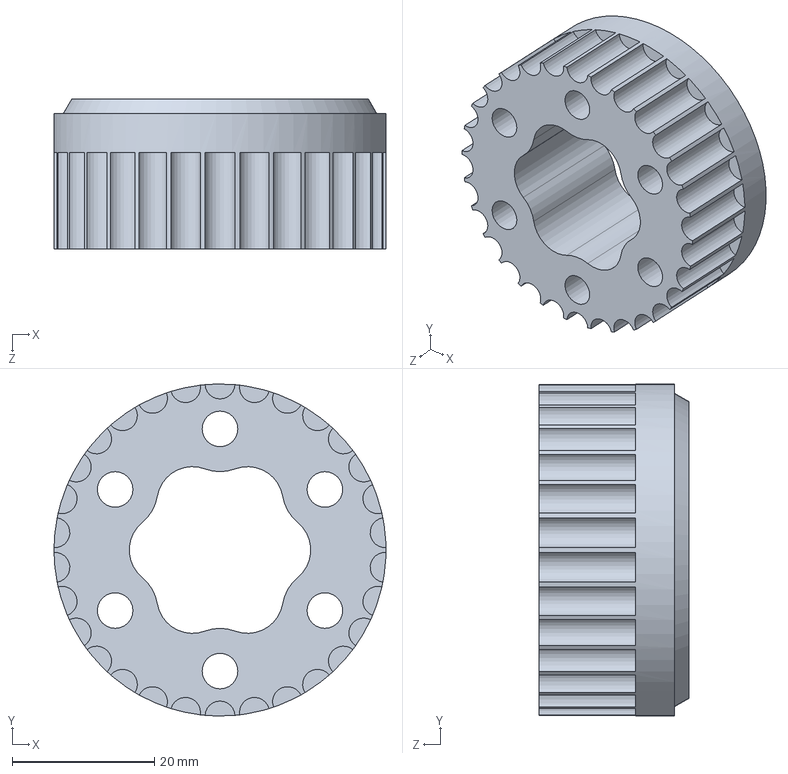
[picture p51: CAD file, 2024-09-26]
solidwork/3D model/HTD - 5M - 30T - pulley.SLDPRT
46.6 x 46.6 x 21.0 mm
