86kkd/millionBoard/solidwork/3D model/Belt-protector.SLDPRT

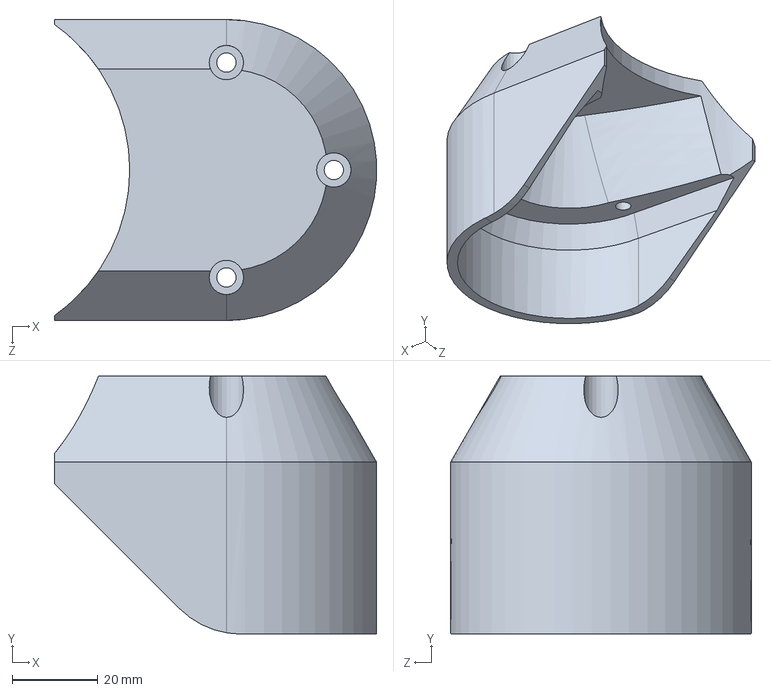
[picture p52: CAD file, 2024-09-26]
solidwork/3D model/Belt-protector.SLDPRT
74.9 x 60.0 x 70.0 mm
