86kkd/millionBoard/solidwork/3D model/radial ball bearing_68_din.sldprt

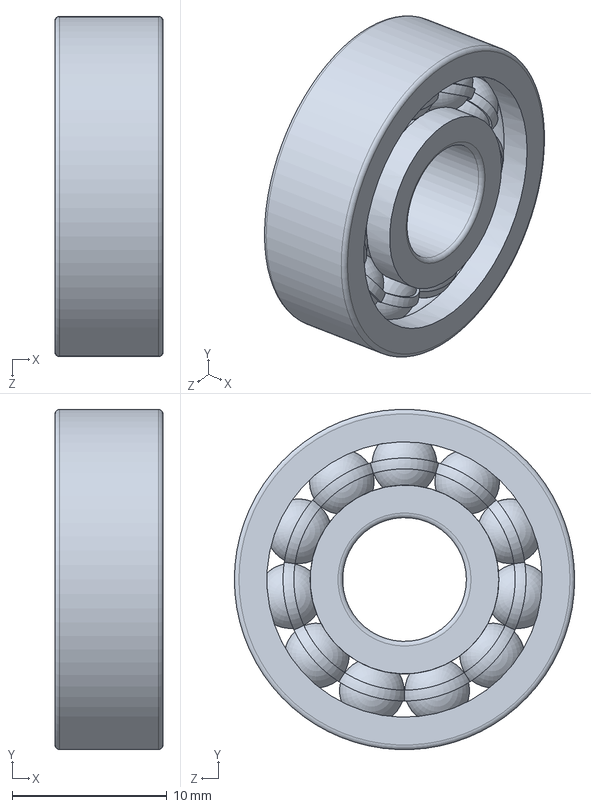
[picture p53: CAD file, 2024-09-26]
solidwork/3D model/radial ball bearing_68_din.sldprt
7.00 x 22.0 x 22.0 mm
