86kkd/millionBoard/solidwork/3D model/Rubber-truck-holder.SLDPRT

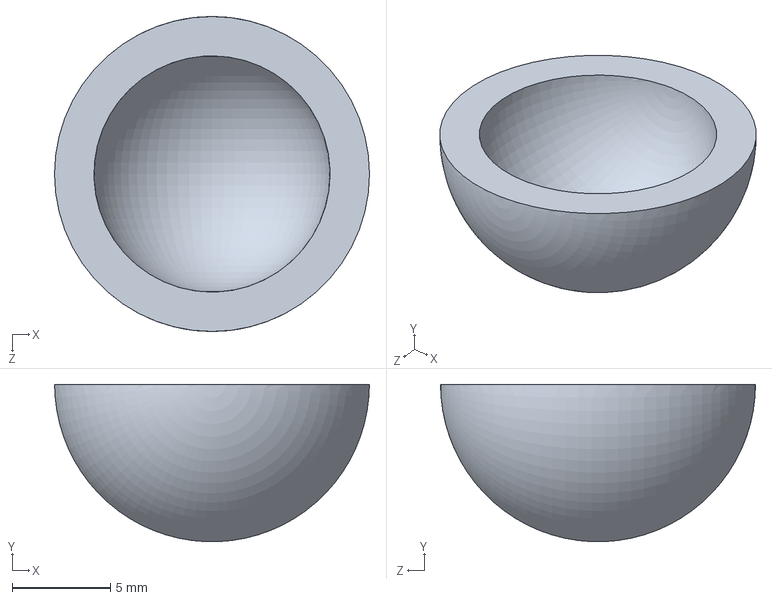
[picture p54: CAD file, 2024-09-26]
solidwork/3D model/Rubber-truck-holder.SLDPRT
16.0 x 7.99 x 16.0 mm
