86kkd/millionBoard/solidwork/3D model/Pulley_HDT_5M_15T.SLDPRT

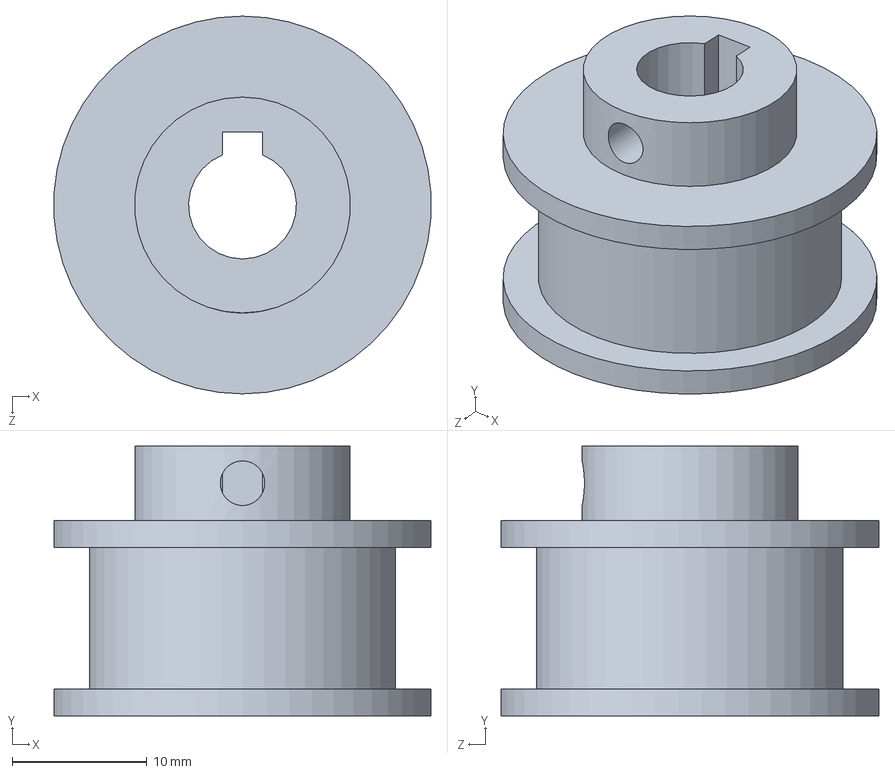
[picture p55: CAD file, 2024-09-26]
solidwork/3D model/Pulley_HDT_5M_15T.SLDPRT
27.9 x 20.0 x 28.0 mm
