86kkd/millionBoard/solidwork/测试装配体.SLDASM

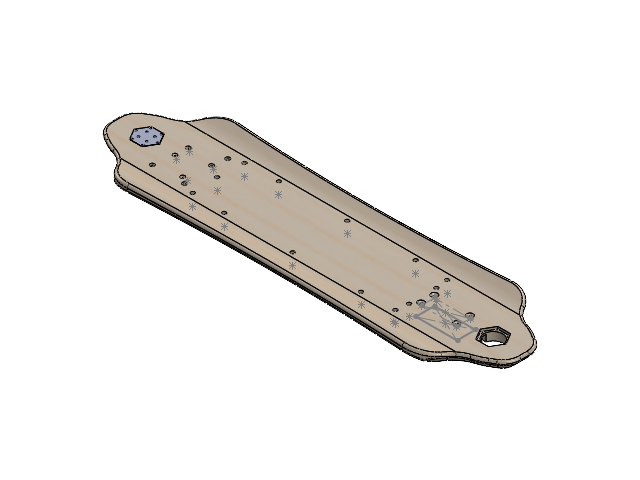
[picture p56: CAD file, 2025-04-06]
solidwork/测试装配体.SLDASM
Deck
垫片-上
垫片-下
主板保护
Electronics enclosure
