86kkd/millionBoard/(list of files, cad)

Other CAD files:
solidwork/Deck1.STL
solidwork/3D model/Motor-mount-right.SLDPRT
solidwork/3D model/DIN 967 - M5 x 45 - Z --- 33.4S.sldprt
solidwork/3D model/Deck.SLDASM
solidwork/3D model/Deck.SLDPRT
solidwork/3D model/Electronics enclosure.SLDPRT
solidwork/3D model/Hexagon Nut ISO 4034 - M5 - S.sldprt
solidwork/3D model/Trucks-main-bolt.SLDPRT
solidwork/3D model/hex nut gradec_din.sldprt
solidwork/3D model/socket head cap screw_din.sldprt
solidwork/3D model/socket thin pilot cap screw_din.sldprt
solidwork/Deck - 副本.SLDPRT
solidwork/Deck.SLDPRT
solidwork/Deck.STL
solidwork/Electronics enclosure.SLDPRT
solidwork/主板保护.SLDPRT
solidwork/垫片-上.SLDPRT
solidwork/垫片-下.SLDPRT
