86kkd/millionBoard/pcb/new_dc-dc/new_dc-dc.kicad_pcb

## KiCad design pcb/new_dc-dc/new_dc-dc.kicad_pcb (2025-05-02)

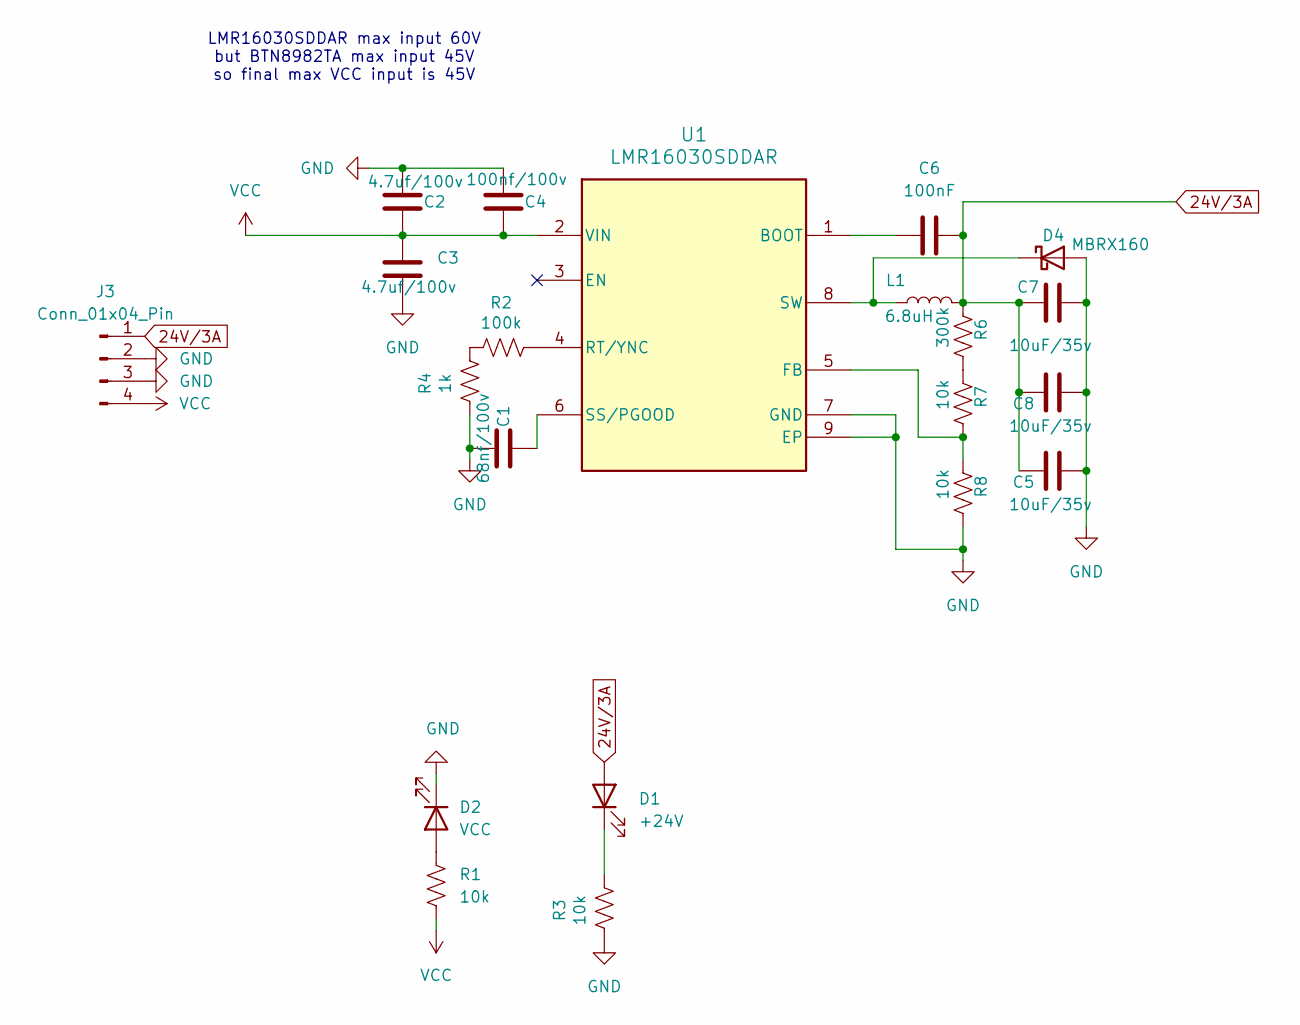
[picture p57: schematic new_dc-dc.kicad_sch]

Parts:
C1: 68nf/100v; C_0603_1608Metric
C2, C3: 4.7uf/100v; C_1210_3225Metric
C4: 100nf/100v; C_0603_1608Metric
C5, C7, C8: 10uF/35v; C_1210_3225Metric
C6: 100nF; C_0603_1608Metric
D1: +24V; LED_0603_1608Metric
D2: VCC; LED_0603_1608Metric
D4: MBRX160; D_SOD-123
J3: Conn_01x04_Pin
L1: 6.8uH; L_Chilisin_BMRA00040420
R1, R3, R7, R8: 10k; R_0603_1608Metric
R2: 100k; R_0603_1608Metric
R4: 1k; R_0603_1608Metric
R6: 300k; R_0603_1608Metric
U1: LMR16030SDDAR; TI_SO-PowerPAD-8_ThermalVias

Connections:
24V/3A: C5.2, C6.1, C7.1, C8.2, D1.2 (A), J3.1, L1.2, R6.1
GND: C1.2, C2.2, C3.2, C4.1, C5.1, C7.2, C8.1, D2.1 (K), D4.2 (A), J3.2, J3.3, R3.2, R4.2, R8.2, U1.7 (GND), U1.9 (EP)
unnamed: D1.1 (K), R3.1
unnamed: D2.2 (A), R1.2
unnamed: D4.1 (K), L1.1, U1.8 (SW)
unnamed: R2.2, R4.1
unnamed: R6.2, R7.1
unnamed: C6.2, U1.1 (BOOT)
unnamed: R7.2, R8.1, U1.5 (FB)
unnamed: R2.1, U1.4 (RT/YNC)
unnamed: C1.1, U1.6 (SS/PGOOD)
VCC: C2.1, C3.1, C4.2, J3.4, R1.1, U1.2 (VIN)

Notes on the sheet:
LMR16030SDDAR max input 60V but BTN8982TA max input 45V so final max VCC input is 45V

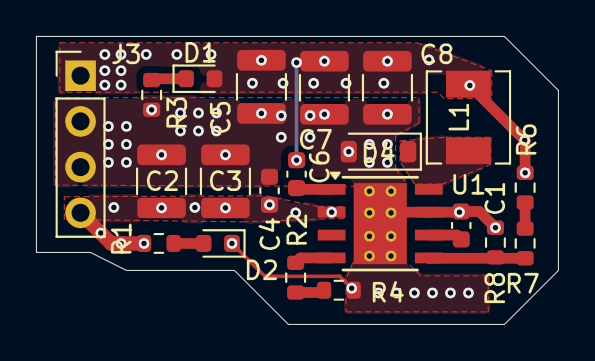
[picture p58: board new_dc-dc.kicad_pcb from above]

Board: 6 copper layers, 29.0 x 16.0 mm, 21 parts (0 on the bottom side), 12 nets.
