86kkd/millionBoard/pcb/skateboard.kicad_pcb

## KiCad design pcb/skateboard.kicad_pcb (2025-05-02)

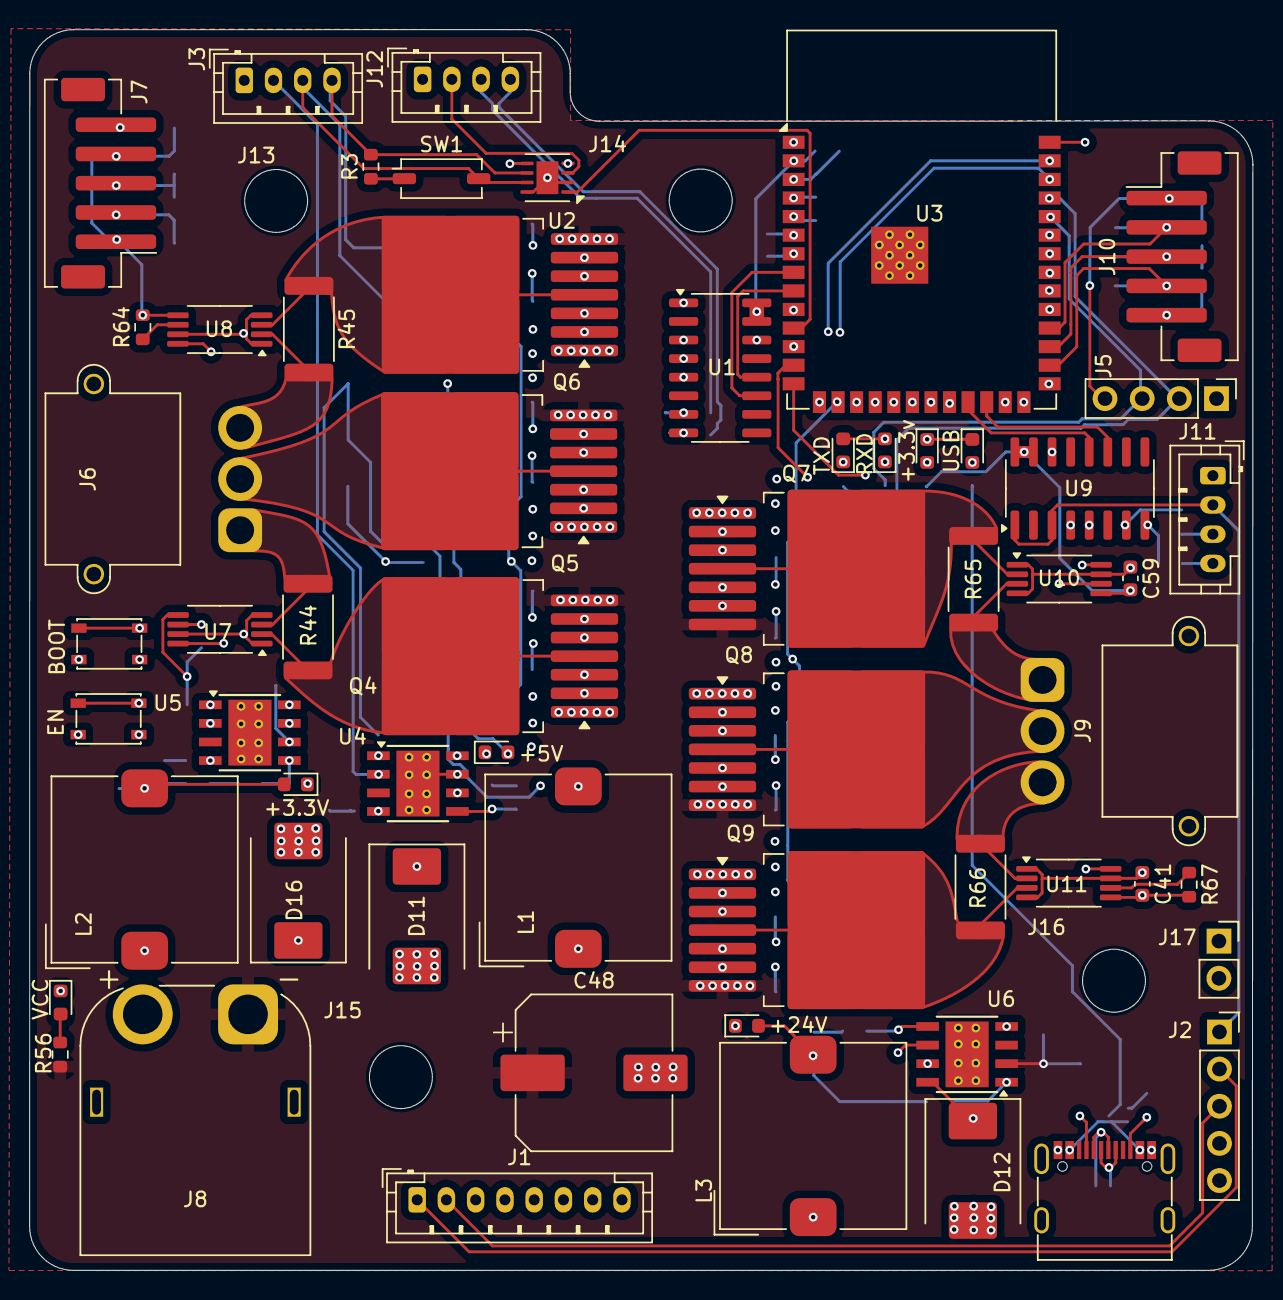
[picture p59: board skateboard.kicad_pcb from above]

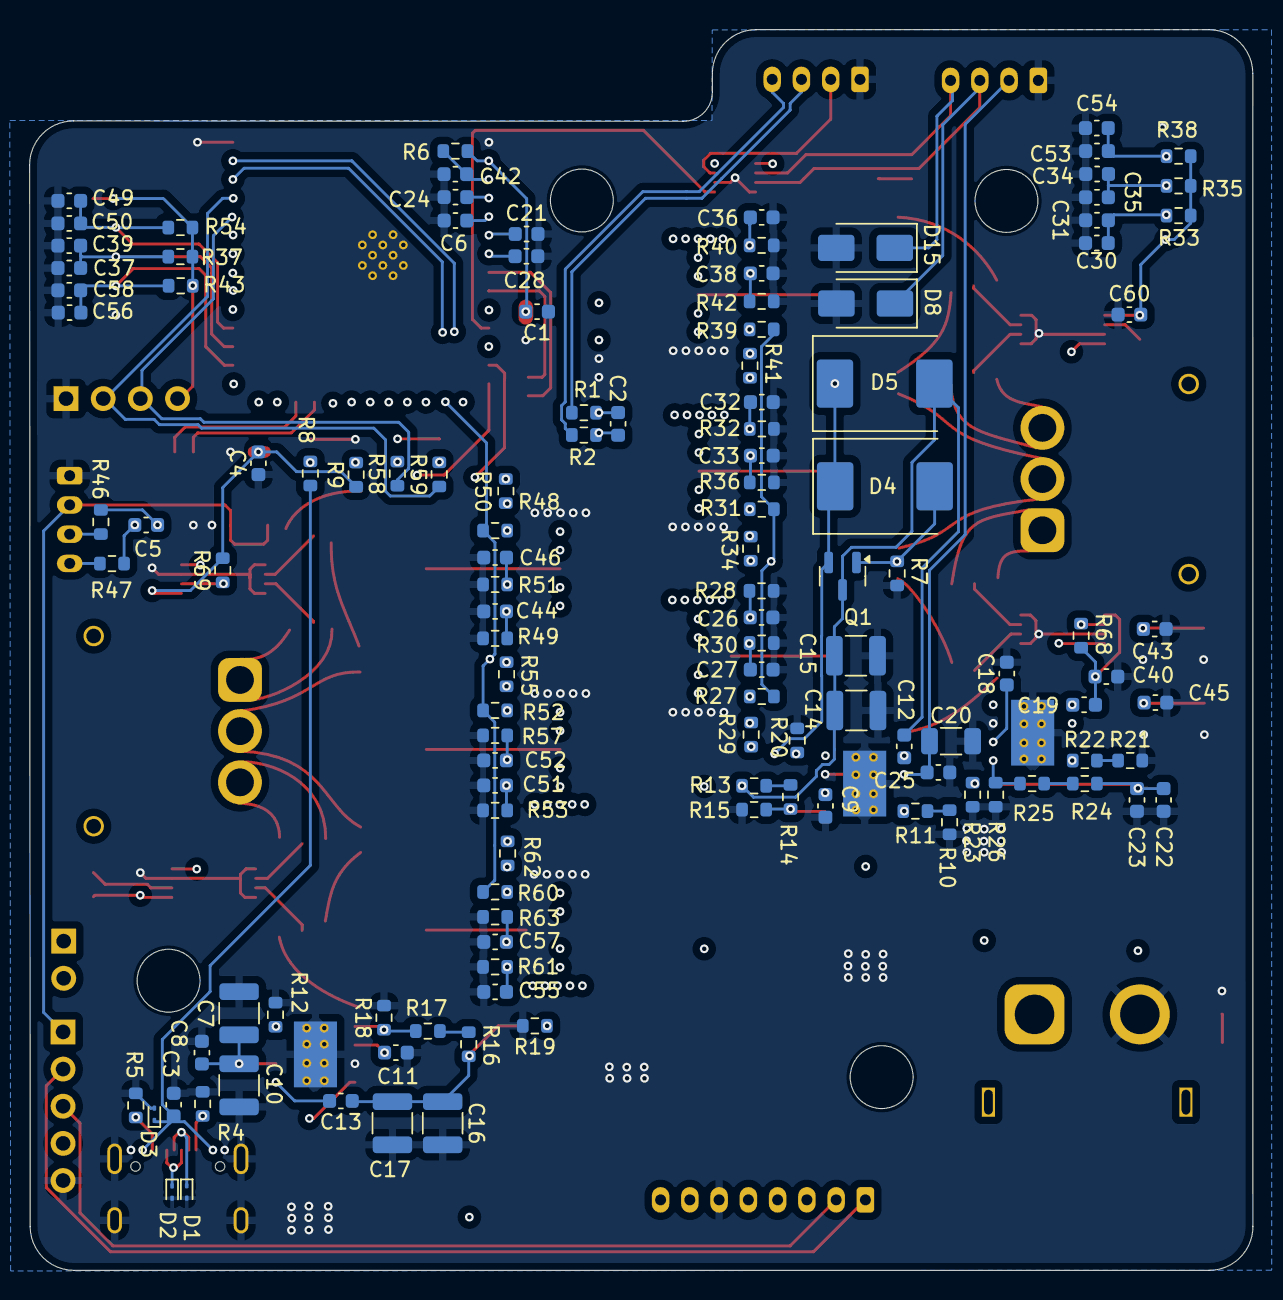
[picture p60: board skateboard.kicad_pcb from below]

Board: 4 copper layers, 83.6 x 84.8 mm, 186 parts (124 on the bottom side), 123 nets.

Parts:
3.3V4: VCC; LED_0603_1608Metric
C1, C4: 10uF; C_0603_1608Metric
C2, C5, C12, C13, C19, C27, C30, C33, C35, C38, C39, C40, C41, C46, C49, C52, C54, C57, C58, C59, C60: 100nF; C_0603_1608Metric
C3, C6, C8, C21, C24, C28: 100nf; C_0603_1608Metric
C7, C10: 10uf/50v; C_1210_3225Metric
C9, C18: 47nF; C_0603_1608Metric
C11: 68nF; C_0603_1608Metric
C14, C15: 10uF/16v; C_1210_3225Metric
C16, C17: 10uF/35v; C_1210_3225Metric
C20: 4.7uf/50v; C_1206_3216Metric
C22, C23: 10uF/10v; C_0603_1608Metric
C25: 100nf/50v; C_0603_1608Metric
C26, C32, C36, C44, C51, C55: 1nF; C_0603_1608Metric
C31, C34, C37, C50, C53, C56: 20pF; C_0603_1608Metric
C42, C43, C45: 1uF; C_0603_1608Metric
C48: 220uf; CP_Elec_10x10.5
D1, D2, D3: ESD9B5.0ST5G; D_SOD-923
D4, D5, D11, D12, D16: B560C; D_SMC
D6: USB; LED_0603_1608Metric
D7: +3.3v; LED_0603_1608Metric
D8, D15: SMAJ13CA; D_SMA
D9: RXD; LED_0603_1608Metric
D10: TXD; LED_0603_1608Metric
D13: +24V; LED_0603_1608Metric
D14: +5V; LED_0603_1608Metric
D17: +3.3V; LED_0603_1608Metric
J1: RC555; JST_PH_B8B-PH-K_1x08_P2.00mm_Vertical
J2: pa1010d; PinSocket_1x05_P2.54mm_Vertical
J3: can_sensor; JST_PH_B4B-PH-K_1x04_P2.00mm_Vertical
J4: USB_C_Receptacle_USB2.0_16P; USB_C_Receptacle_G-Switch_GT-USB-7010ASV
J5: UART; PinHeader_1x04_P2.54mm_Vertical
J6, J9: TB_MOTOR; AMASS_MR30PW-M_1x03_P3.50mm_Horizontal
J7, J10: PH_2.0; JST_PH_B5B-PH-SM4-TB_1x05-1MP_P2.00mm_Vertical
J8: power; AMASS_XT60PW-M_1x02_P7.20mm_Horizontal
J11: adc_sensor2; JST_PH_B4B-PH-K_1x04_P2.00mm_Vertical
J12: adc_sensor1; JST_PH_B4B-PH-K_1x04_P2.00mm_Vertical
J13, J14, J15, J16: Conn_01x01_Pin; MountingHole_4.3mm_M4
J17: Conn_01x02_Pin; PinSocket_1x02_P2.54mm_Vertical
L1: 47uH; L_TDK_SLF12565
L2: 10uH; L_TDK_SLF12565
L3: 22uH; L_TDK_SLF12565
Q1: AO3401A; SOT-23
Q4, Q5, Q6, Q7, Q8, Q9: BTN8982TA; TO-263-7_TabPin8
R1, R2, R46, R47: 100; R_0603_1608Metric
R3: 120; R_0603_1608Metric
R4, R5: 5K1; R_0603_1608Metric
R6, R8, R9, R58, R59: 10K; R_0603_1608Metric
R7, R15, R17, R18, R19, R20, R23, R26, R27, R29, R31, R34, R39, R41, R48, R50, R52, R55, R56, R60, R62: 10k; R_0603_1608Metric
R10, R21: 1.3k; R_0603_1608Metric
R11, R22: 62k; R_0603_1608Metric
R12: 100k; R_0603_1608Metric
R13: 56k; R_0603_1608Metric
R14: 680; R_0603_1608Metric
R16: 300k; R_0603_1608Metric
R24: 33k; R_0603_1608Metric
R25, R28, R32, R40, R49, R53, R61: 1k; R_0603_1608Metric
R30, R36, R42, R51, R57, R63: 0.51k; R_0603_1608Metric
R33, R35, R37, R38, R43, R54: 3.3k; R_0603_1608Metric
R44, R45, R65, R66: 0.001; R_2512_6332Metric
R64, R67, R68, R69: 200k; R_0603_1608Metric
SW1: SW_SPST; SW_DIP_SPSTx01_Slide_Copal_CHS-01A_W5.08mm_P1.27mm_JPin
SW2: BOOT; SW_SPST_PTS810
SW3: EN; SW_SPST_PTS810
U1, U9: HX711; SOP-16_3.9x9.9mm_P1.27mm
U2: SIT1042AQT/3; DFN-8-1EP_3x3mm_P0.65mm_EP1.5x2.25mm
U3: ESP32-S3-WROOM-1
U4, U5, U6: LMR16030SDDAR; TI_SO-PowerPAD-8_ThermalVias
U7, U8, U10, U11: INA240A2PW; TSSOP-8_4.4x3mm_P0.65mm

Connections:
24V/3A: C13.1, C16.1, C17.2, C20.2, C25.1, D13.2 (A), J3.2, L3.2, R16.1, U4.2 (VIN)
+3.3V: C1.2, C4.2, C19.1, C22.1, C23.2, C40.2, C41.2, C59.2, C60.2, D9.2 (A), D10.2 (A), D17.2 (A), J1.8, J5.4, J7.1, J10.1, L2.2, R6.1, R9.1, R24.1, R33.2, R35.2, R37.2, R38.2, R43.2, R54.2, R64.2, R67.2, R68.2, R69.2, U1.15 (RATE), U1.16 (DVDD), U2.5 (VIO), U3.2 (3V3), U7.5 (V+), U8.5 (V+), U9.15 (RATE), U9.16 (DVDD), U10.5 (V+), U11.5 (V+)
+5V: D4.1 (K), D5.1 (K), D14.2 (A), J2.1, J11.2, J12.2, Q1.2 (S), U1.1 (VSUP), U1.3 (AVDD), U2.3 (VCC), U5.2 (VIN), U9.1 (VSUP), U9.3 (AVDD)
/foc1/A0: C6.1, U3.5 (IO5), U7.8
/foc1/A1: C24.1, U3.4 (IO4), U8.8
/foc1/A2: C26.1, Q4.6 (IS), R28.1
/foc1/A3: C32.1, Q5.6 (IS), R32.1
/foc1/IN_1: R29.2, U3.19 (IO11)
/foc1/IN_2: R34.2, U3.18 (IO10)
/foc1/IN_3: R41.2, U3.17 (IO9)
/foc1/MOT_A: C30.1, C31.2, J7.2, R33.1, U3.31 (IO38)
/foc1/MOT_B: C34.2, C35.1, J7.3, R35.1, U3.34 (IO41)
/foc1/MOT_C: C53.2, C54.1, J7.4, R38.1, U3.35 (IO42)
/foc2/A0: C21.1, U3.6 (IO6), U10.8
/foc2/A1: C28.1, U3.7 (IO7), U11.8
/foc2/A2: C44.1, Q7.6 (IS), R49.1
/foc2/A3: C51.1, Q8.6 (IS), R53.1
/foc2/IN_1: R50.2, U3.22 (IO14)
/foc2/IN_2: R55.2, U3.21 (IO13)
/foc2/IN_3: R62.2, U3.20 (IO12)
/foc2/MOT_A: C49.1, C50.2, J10.2, R54.1, U3.30 (IO37)
/foc2/MOT_B: C37.2, C39.1, J10.3, R37.1, U3.29 (IO36)
/foc2/MOT_C: C56.2, C58.1, J10.4, R43.1, U3.28 (IO35)
/mcu/Battery_5V: C12.1, C14.1, C15.2, D5.2 (A), L1.2, Q1.3 (D), R13.1
Battery_RXD: J17.2, U3.25 (IO48)
Battery_TXD: J17.1, U3.26 (IO45)
CANH: D8.1 (A1), J3.3, SW1.2 (B), U2.7 (CANH)
CANL: D15.1 (A1), J3.4, R3.2, U2.6 (CANL)
DOUT_1: U1.12 (DOUT), U3.9 (IO16)
DOUT_2: U3.23 (IO21), U9.12 (DOUT)
EN: C42.1, C45.1, R6.2, SW3.1, U3.3 (EN)
GND: 3.3V4.1 (K), C1.1, C3.1, C4.1, C6.2, C7.2, C8.2, C9.2, C10.1, C11.2, C14.2, C15.1, C16.2, C17.1, C18.2, C20.1, C21.2, C22.2, C23.1, C24.2, C25.2, C26.2, C27.2, C28.2, C30.2, C31.1, C32.2, C33.2, C34.1, C35.2, C36.2, C37.1, C38.2, C39.2, C40.1, C41.1, C42.2, C43.2, C44.2, C45.2, C46.2, C48.2, C49.2, C50.1, C51.2, C52.2, C53.1, C54.2, C55.2, C56.1, C57.2, C58.2, C59.1, C60.1, D1.2 (A2), D2.2 (A2), D3.2 (A2), D6.1 (K), D7.1 (K), D8.2 (A2), D11.2 (A), D12.2 (A), D15.2 (A2), D16.2 (A), J1.6, J2.5, J3.1, J4.A1 (GND), J4.A12 (GND), J4.B1 (GND), J4.B12 (GND), J4.S1 (SHIELD), J5.1, J7.5, J8.2, J10.5, J11.1, J12.1, Q4.1, Q5.1, Q6.1, Q7.1, Q8.1, Q9.1, R4.1, R5.1, R7.2, R10.2, R12.2, R15.2, R18.2, R19.2, R20.2, R21.2, R23.2, R26.2, R28.2, R30.2, R32.2, R36.2, R40.2, R42.2, R49.2, R51.2, R53.2, R57.2, R61.2, R63.2, SW2.2, SW3.2, U1.4 (VFB), U1.5 (AGND), U1.14 (XI), U2.2 (GND), U2.8 (STB), U2.9 (EP), U3.1 (GND), U3.40 (GND), U3.41 (GND), U4.7 (GND), U4.9 (EP), U5.7 (GND), U5.9 (EP), U6.7 (GND), U6.9 (EP), U7.1 (GND), U7.4 (GND), U7.7 (REF1), U8.1 (GND), U8.4 (GND), U8.7 (REF1), U9.4 (VFB), U9.5 (AGND), U9.14 (XI), U10.1 (GND), U10.4 (GND), U10.7 (REF1), U11.1 (GND), U11.4 (GND), U11.7 (REF1)
INA1+: J12.4, R2.2
INA1-: J12.3, R1.2
INA2+: J11.4, R47.2
INA2-: J11.3, R46.2
IO0: C43.1, SW2.1, U3.27 (IO0)
IRQ: J1.5, U3.39 (IO1)
MISO: J1.4, U3.15 (IO3)
MOSI: J1.3, U3.12 (IO8)
MOTO_POWER: R27.2, R31.2, R39.2, R48.2, R52.2, R60.2, U3.16 (IO46)
unnamed: 3.3V4.2 (A), R56.2
unnamed: D6.2 (A), R8.2
unnamed: D7.2 (A), R9.2
unnamed: D9.1 (K), R58.2
unnamed: D10.1 (K), R59.2
unnamed: D11.1 (K), L1.1, U4.8 (SW)
unnamed: D12.1 (K), L3.1, U6.8 (SW)
unnamed: D13.1 (K), R19.1
unnamed: D14.1 (K), R20.1
unnamed: D16.1 (K), L2.1, U5.8 (SW)
unnamed: D17.1 (K), R23.1
unnamed: J4.A5 (CC1), R4.2
unnamed: J4.B5 (CC2), R5.2
unnamed: J6.1, R44.1, U7.3 (-)
unnamed: J6.2, Q5.4, Q5.8
unnamed: J6.3, R45.2, U8.2 (+)
unnamed: J9.1, R65.1, U10.3 (-)
unnamed: J9.2, Q8.4, Q8.8
unnamed: J9.3, R66.2, U11.2 (+)
unnamed: Q4.2 (IN), R29.1
unnamed: Q4.3 (INH), R27.1
unnamed: C27.1, Q4.5 (SR), R30.1
unnamed: Q5.2 (IN), R34.1
unnamed: Q5.3 (INH), R31.1
unnamed: C33.1, Q5.5 (SR), R36.1
unnamed: Q6.2 (IN), R41.1
unnamed: Q6.3 (INH), R39.1
unnamed: C36.1, Q6.6 (IS), R40.1
unnamed: C38.1, Q6.5 (SR), R42.1
unnamed: Q7.2 (IN), R50.1
unnamed: Q7.3 (INH), R48.1
unnamed: C46.1, Q7.5 (SR), R51.1
unnamed: Q8.2 (IN), R55.1
unnamed: Q8.3 (INH), R52.1
unnamed: C52.1, Q8.5 (SR), R57.1
unnamed: Q9.2 (IN), R62.1
unnamed: Q9.3 (INH), R60.1
unnamed: C55.1, Q9.6 (IS), R61.1
unnamed: C57.1, Q9.5 (SR), R63.1
unnamed: R10.1, R11.2
unnamed: R13.2, R14.1
unnamed: R16.2, R17.1
unnamed: R21.1, R22.2
unnamed: R24.2, R25.1
unnamed: R3.1, SW1.1 (A)
unnamed: C2.1, R2.1, U1.8 (INA+)
unnamed: C2.2, R1.1, U1.7 (INA-)
unnamed: C12.2, U4.1 (BOOT)
unnamed: R14.2, R15.1, U4.5 (FB)
unnamed: R11.1, U4.4 (RT/YNC)
unnamed: C9.1, U4.6 (SS/PGOOD)
unnamed: C19.2, U5.1 (BOOT)
unnamed: R25.2, R26.1, U5.5 (FB)
unnamed: R22.1, U5.4 (RT/YNC)
unnamed: C18.1, U5.6 (SS/PGOOD)
unnamed: C13.2, U6.1 (BOOT)
unnamed: R17.2, R18.1, U6.5 (FB)
unnamed: R12.1, U6.4 (RT/YNC)
unnamed: C11.1, U6.6 (SS/PGOOD)
unnamed: Q4.4, Q4.8, R44.2, U7.2 (+)
unnamed: R68.1, U7.6 (REF2)
unnamed: Q6.4, Q6.8, R45.1, U8.3 (-)
unnamed: R64.1, U8.6 (REF2)
unnamed: C5.1, R47.1, U9.8 (INA+)
unnamed: C5.2, R46.1, U9.7 (INA-)
unnamed: Q7.4, Q7.8, R65.2, U10.2 (+)
unnamed: R69.1, U10.6 (REF2)
unnamed: Q9.4, Q9.8, R66.1, U11.3 (-)
unnamed: R67.1, U11.6 (REF2)
PD_SCK1: U1.11 (PD_SCK), U3.8 (IO15)
PD_SCK2: U3.24 (IO47), U9.11 (PD_SCK)
RST: J1.7, U3.38 (IO2)
RXD_SENSOR: U2.4 (RXD), U3.10 (IO17)
SCK: J1.2, J2.3, U3.33 (IO40)
SDA: J1.1, J2.2, U3.32 (IO39)
TXD_SENSOR: U2.1 (TXD), U3.11 (IO18)
U0_RXD: J5.3, R58.1, U3.36 (RXD0)
U0_TXD: J5.2, R59.1, U3.37 (TXD0)
USB_D+: D2.1 (A1), J4.A6 (D+), J4.B6 (D+), U3.14 (USB_D+)
USB_D-: D1.1 (A1), J4.A7 (D-), J4.B7 (D-), U3.13 (USB_D-)
VBUS: C3.2, D3.1 (A1), D4.2 (A), J4.A4 (VBUS), J4.A9 (VBUS), J4.B4 (VBUS), J4.B9 (VBUS), Q1.1 (G), R7.1, R8.1
VCC: C7.1, C8.1, C10.2, C48.1, J8.1, Q4.7, Q5.7, Q6.7, Q7.7, Q8.7, Q9.7, R56.1, U6.2 (VIN)
