86kkd/millionBoard/pcb/battery/battery.kicad_pcb

## KiCad design pcb/battery/battery.kicad_pcb (2025-04-06)

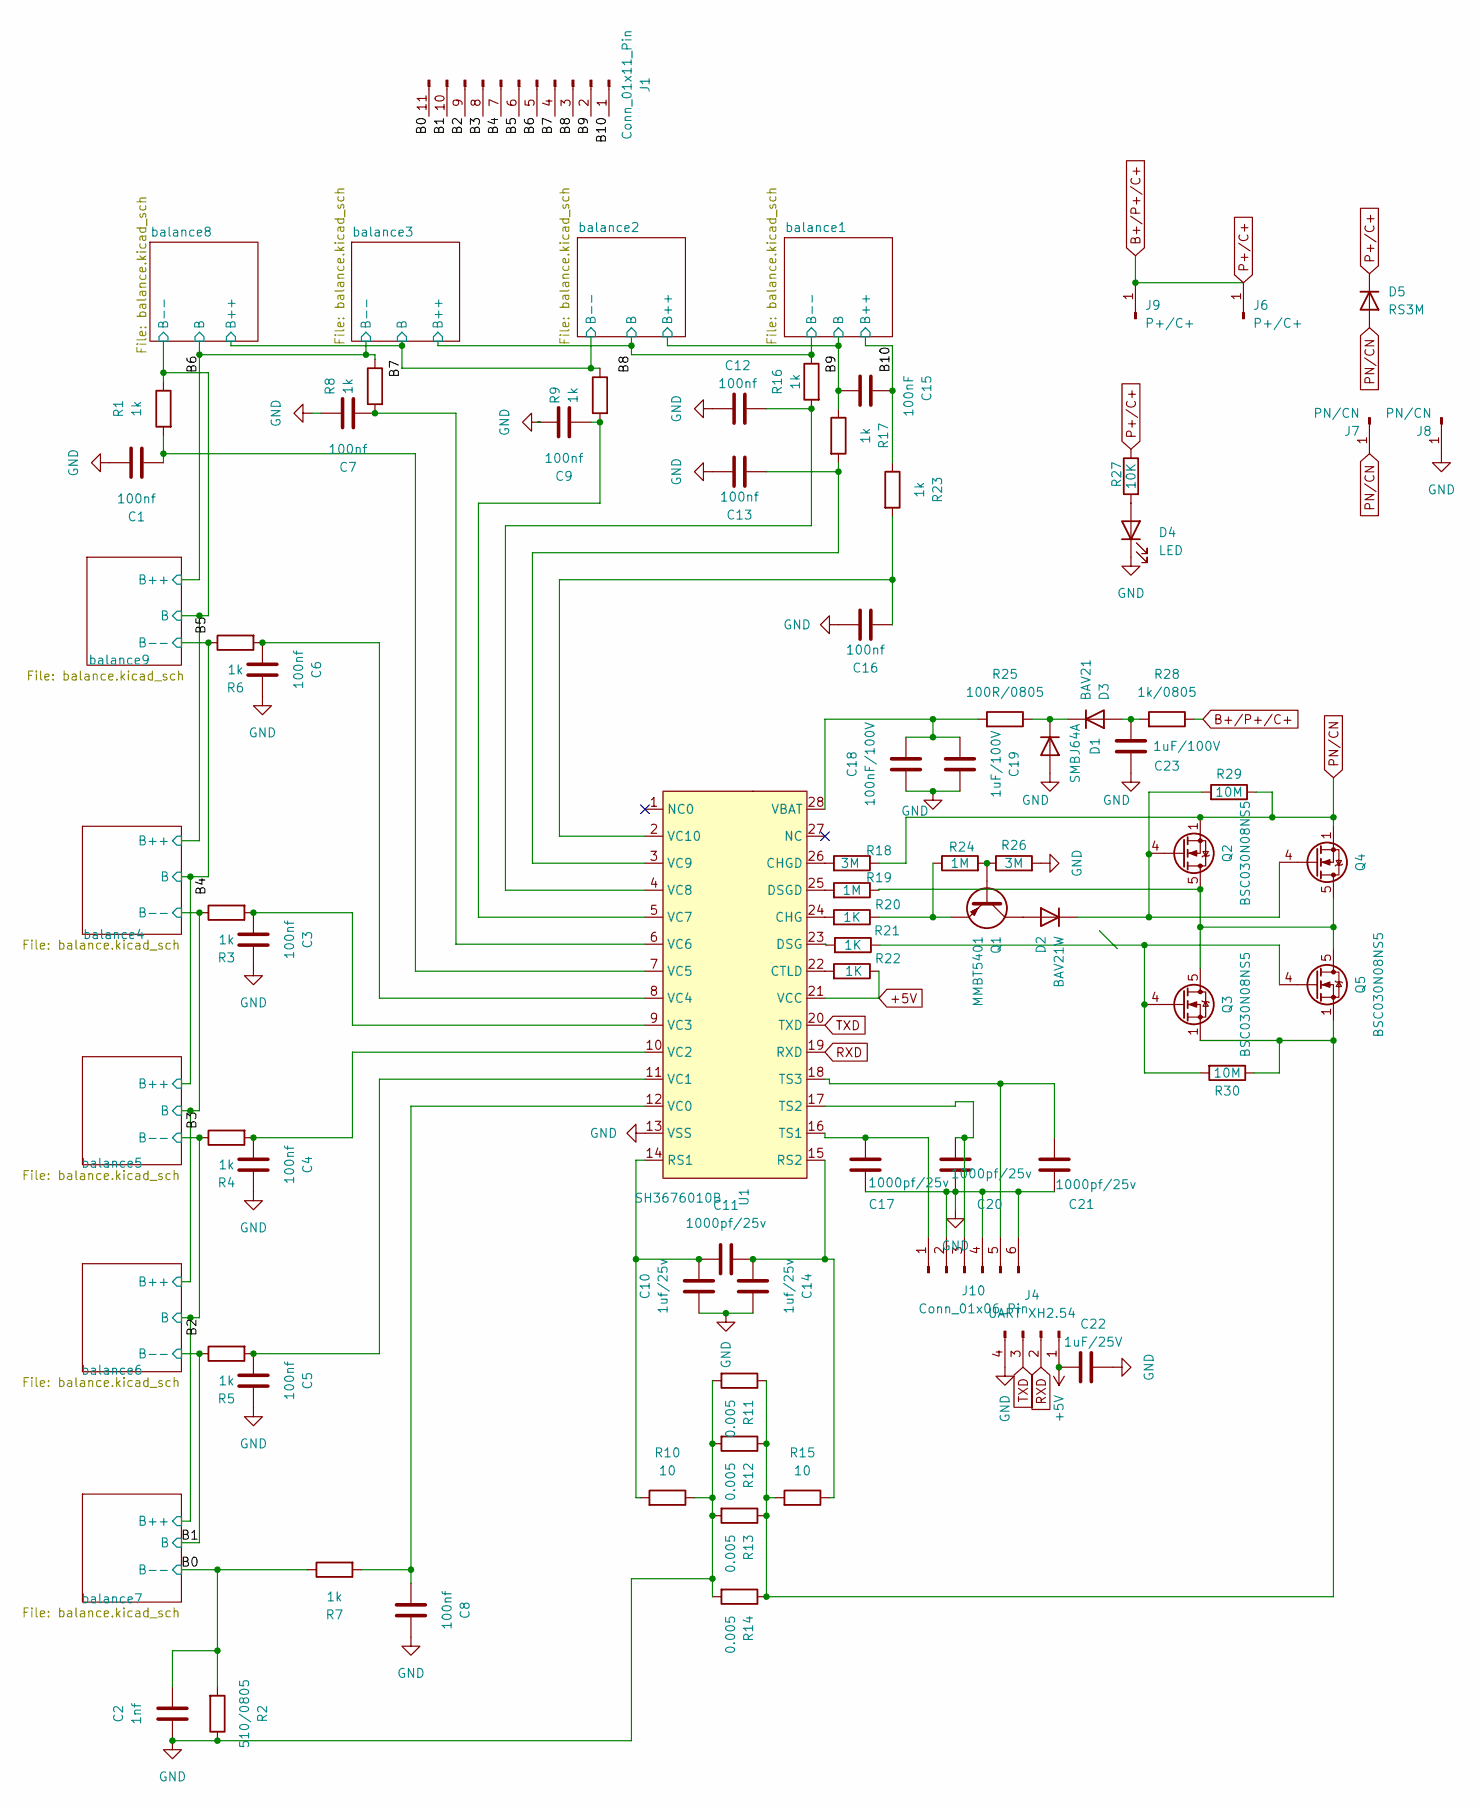
[picture p61: schematic battery.kicad_sch]

Parts:
C1, C3, C4, C5, C6, C7, C8, C9, C12, C13, C16: 100nf; C_0603_1608Metric
C2: 1nf; C_0603_1608Metric
C10, C14: 1uf/25v; C_0603_1608Metric
C11, C17, C20, C21: 1000pf/25v; C_0603_1608Metric
C15: 100nF; C_0603_1608Metric
C18: 100nF/100V; C_0603_1608Metric
C19, C23: 1uF/100V; C_0603_1608Metric
C22: 1uF/25V; C_0603_1608Metric
D1: SMBJ64A; D_SMB-SMC_Universal_Handsoldering
D2: BAV21W; D_SOD-123
D3: BAV21; D_SOD-123
D4: LED; LED_0603_1608Metric
D5: RS3M; D_SMB-SMC_Universal_Handsoldering
J1: Conn_01x11_Pin; JST_PH_B11B-PH-K_1x11_P2.00mm_Vertical
J4: UART XH2.54; PinHeader_1x04_P2.54mm_Vertical
J6, J9: P+/C+; MountingHole_2.2mm_M2_DIN965_Pad_TopBottom
J7, J8: PN/CN; MountingHole_2.2mm_M2_DIN965_Pad_TopBottom
J10: Conn_01x06_Pin; JST_PH_B6B-PH-K_1x06_P2.00mm_Vertical
Q1: MMBT5401; SOT-23
Q2, Q3, Q4, Q5: BSC030N08NS5; TDSON-8-1
R1, R3, R4, R5, R6, R7, R8, R9, R16, R17, R23: 1k; R_0603_1608Metric
R2: 510/0805; R_0805_2012Metric
R10, R15: 10; R_0603_1608Metric
R11, R12, R13, R14: 0.005; R_2512_6332Metric
R18, R26: 3M; R_0603_1608Metric
R19, R24: 1M; R_0603_1608Metric
R20, R21, R22: 1K; R_0603_1608Metric
R25: 100R/0805; R_0805_2012Metric
R27: 10K; R_0603_1608Metric
R28: 1k/0805; R_0805_2012Metric
R29, R30: 10M; R_0603_1608Metric
U1: SH3676010B; TSSOP-28_4.4x9.7mm_P0.65mm

Connections:
+5V: C22.1, J4.1, R22.1, U1.21 (VCC)
/B0: C2.2, J1.11, R2.2, R7.1; also elsewhere on the board
/B1: J1.10, R5.1; also elsewhere on the board
/B2: J1.9, R4.1; also elsewhere on the board
/B3: J1.8, R3.1; also elsewhere on the board
/B4: J1.7, R6.1; also elsewhere on the board
/B5: J1.6, R1.1; also elsewhere on the board
/B6: J1.5, R8.1; also elsewhere on the board
/B7: J1.4, R9.1; also elsewhere on the board
/B8: J1.3, R16.1; also elsewhere on the board
/B9: C15.2, J1.2, R17.1; also elsewhere on the board
/B10: C15.1, J1.1, R23.1; also elsewhere on the board
B+/P+/C+: D5.1 (K), J6.1, J9.1, R27.1, R28.1
GND: C1.1, C2.1, C3.1, C4.1, C5.1, C6.1, C7.1, C8.1, C9.1, C10.1, C12.1, C13.2, C14.1, C16.2, C17.2, C18.2, C19.1, C20.2, C21.2, C22.2, C23.1, D1.2 (A), D4.1 (K), J4.4, J8.1, J10.2, J10.4, J10.6, R2.1, R10.1, R11.2, R12.2, R13.2, R14.2, R26.2, U1.13 (VSS)
unnamed: D1.1 (K), D3.1 (K), R25.1
unnamed: D2.2 (A), Q1.3 (C)
unnamed: D2.1 (K), Q2.4 (G), Q4.4 (G), R29.2
unnamed: C23.2, D3.2 (A), R28.2
unnamed: D4.2 (A), R27.2
unnamed: C17.1, J10.1, U1.16 (TS1)
unnamed: C20.1, J10.3, U1.17 (TS2)
unnamed: C21.1, J10.5, U1.18 (TS3)
unnamed: Q1.1 (B), R24.2, R26.1
unnamed: Q1.2 (E), R20.1, R24.1
unnamed: Q2.5 (D), Q3.5 (D), Q4.5 (D), Q5.5 (D), R19.1
unnamed: Q3.4 (G), Q5.4 (G), R21.1, R30.2
unnamed: Q3.1 (S), Q3.2 (S), Q3.3 (S), Q5.1 (S), Q5.2 (S), Q5.3 (S), R11.1, R12.1, R13.1, R14.1, R15.2, R30.1
unnamed: R20.2, U1.24 (CHG)
unnamed: R18.2, U1.26 (CHGD)
unnamed: R22.2, U1.22 (CTLD)
unnamed: R21.2, U1.23 (DSG)
unnamed: R19.2, U1.25 (DSGD)
unnamed: C10.2, C11.2, R10.2, U1.14 (RS1)
unnamed: C11.1, C14.2, R15.1, U1.15 (RS2)
unnamed: C18.1, C19.2, R25.2, U1.28 (VBAT)
unnamed: C8.2, R7.2, U1.12 (VC0)
unnamed: C5.2, R5.2, U1.11 (VC1)
unnamed: C4.2, R4.2, U1.10 (VC2)
unnamed: C3.2, R3.2, U1.9 (VC3)
unnamed: C6.2, R6.2, U1.8 (VC4)
unnamed: C1.2, R1.2, U1.7 (VC5)
unnamed: C7.2, R8.2, U1.6 (VC6)
unnamed: C9.2, R9.2, U1.5 (VC7)
unnamed: C12.2, R16.2, U1.4 (VC8)
unnamed: C13.1, R17.2, U1.3 (VC9)
unnamed: C16.1, R23.2, U1.2 (VC10)
PN/CN: D5.2 (A), J7.1, Q2.1 (S), Q2.2 (S), Q2.3 (S), Q4.1 (S), Q4.2 (S), Q4.3 (S), R18.1, R29.1
RXD: J4.2, U1.19 (RXD)
TXD: J4.3, U1.20 (TXD)

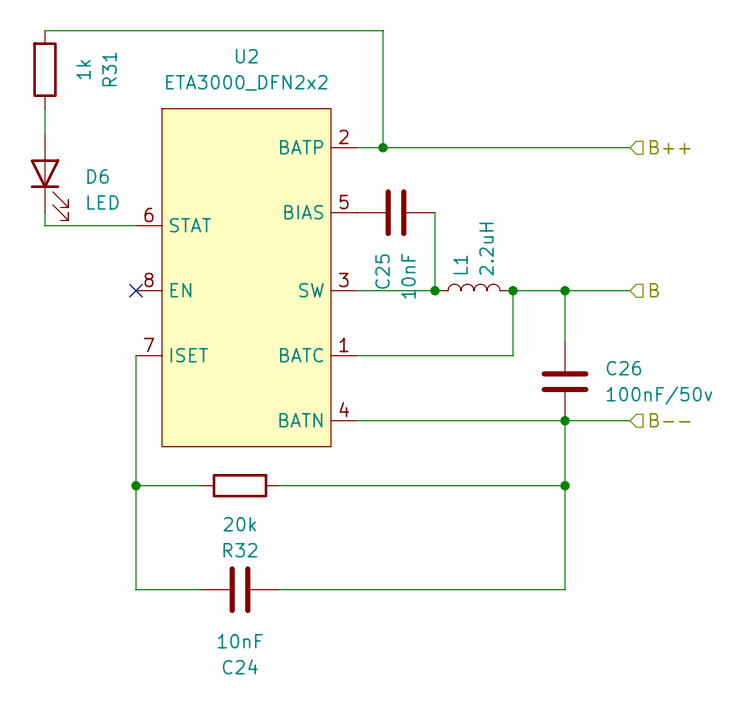
[picture p62: schematic balance.kicad_sch]

Parts:
C24, C25: 10nF; C_0603_1608Metric
C26: 100nF/50v; C_0603_1608Metric
D6: LED; LED_0603_1608Metric
L1: 2.2uH; L_Neosid_Ms42
R31: 1k; R_0603_1608Metric
R32: 20k; R_0603_1608Metric
U2: ETA3000_DFN2x2; DFN-8_2x2mm_P0.5mm

Connections:
/B8: C24.2, C26.2, R32.2, U2.4 (BATN); also elsewhere on the board
/B9: C26.1, L1.2, U2.1 (BATC); also elsewhere on the board
/B10: R31.2, U2.2 (BATP); also elsewhere on the board
unnamed: D6.2 (A), R31.1
unnamed: D6.1 (K), U2.6 (STAT)
unnamed: C25.1, U2.5 (BIAS)
unnamed: C24.1, R32.1, U2.7 (ISET)
unnamed: C25.2, L1.1, U2.3 (SW)

Parts of its further copies:
C27, C28, C30, C31, C33, C34, C36, C37, C39, C40, C42, C43, C45, C46, C48, C49: 10nF; C_0603_1608Metric
C29, C32, C35, C38, C41, C44, C47, C50: 100nF/50v; C_0603_1608Metric
D7, D8, D9, D10, D11, D12, D13, D14: LED; LED_0603_1608Metric
L2, L3, L4, L5, L6, L7, L8, L9: 2.2uH; L_Neosid_Ms42
R33, R35, R37, R39, R41, R43, R45, R47: 1k; R_0603_1608Metric
R34, R36, R38, R40, R42, R44, R46, R48: 20k; R_0603_1608Metric
U3, U4, U5, U6, U7, U8, U9, U10: ETA3000_DFN2x2; DFN-8_2x2mm_P0.5mm

Connections of its further copies:
/B0: C42.2, C44.2, R44.2, U8.4 (BATN); also elsewhere on the board
/B1: C39.2, C41.2, C44.1, L7.2, R42.2, U7.4 (BATN), U8.1 (BATC); also elsewhere on the board
/B2: C36.2, C38.2, C41.1, L6.2, R40.2, R43.2, U6.4 (BATN), U7.1 (BATC), U8.2 (BATP); also elsewhere on the board
/B3: C33.2, C35.2, C38.1, L5.2, R38.2, R41.2, U5.4 (BATN), U6.1 (BATC), U7.2 (BATP); also elsewhere on the board
/B4: C35.1, C48.2, C50.2, L4.2, R39.2, R48.2, U5.1 (BATC), U6.2 (BATP), U10.4 (BATN); also elsewhere on the board
/B5: C45.2, C47.2, C50.1, L9.2, R37.2, R46.2, U5.2 (BATP), U9.4 (BATN), U10.1 (BATC); also elsewhere on the board
/B6: C30.2, C32.2, C47.1, L8.2, R36.2, R47.2, U4.4 (BATN), U9.1 (BATC), U10.2 (BATP); also elsewhere on the board
/B7: C27.2, C29.2, C32.1, L3.2, R34.2, R45.2, U3.4 (BATN), U4.1 (BATC), U9.2 (BATP); also elsewhere on the board
/B8: C29.1, L2.2, R35.2, U3.1 (BATC), U4.2 (BATP); also elsewhere on the board
/B9: R33.2, U3.2 (BATP); also elsewhere on the board
unnamed: D7.2 (A), R33.1
unnamed: D7.1 (K), U3.6 (STAT)
unnamed: D8.2 (A), R35.1
unnamed: D8.1 (K), U4.6 (STAT)
unnamed: D9.2 (A), R37.1
unnamed: D9.1 (K), U5.6 (STAT)
unnamed: D10.2 (A), R39.1
unnamed: D10.1 (K), U6.6 (STAT)
unnamed: D11.2 (A), R41.1
unnamed: D11.1 (K), U7.6 (STAT)
unnamed: D12.2 (A), R43.1
unnamed: D12.1 (K), U8.6 (STAT)
unnamed: D13.2 (A), R45.1
unnamed: D13.1 (K), U9.6 (STAT)
unnamed: D14.2 (A), R47.1
unnamed: D14.1 (K), U10.6 (STAT)
unnamed: C28.1, U3.5 (BIAS)
unnamed: C27.1, R34.1, U3.7 (ISET)
unnamed: C28.2, L2.1, U3.3 (SW)
unnamed: C31.1, U4.5 (BIAS)
unnamed: C30.1, R36.1, U4.7 (ISET)
unnamed: C31.2, L3.1, U4.3 (SW)
unnamed: C34.1, U5.5 (BIAS)
unnamed: C33.1, R38.1, U5.7 (ISET)
unnamed: C34.2, L4.1, U5.3 (SW)
unnamed: C37.1, U6.5 (BIAS)
unnamed: C36.1, R40.1, U6.7 (ISET)
unnamed: C37.2, L5.1, U6.3 (SW)
unnamed: C40.1, U7.5 (BIAS)
unnamed: C39.1, R42.1, U7.7 (ISET)
unnamed: C40.2, L6.1, U7.3 (SW)
unnamed: C43.1, U8.5 (BIAS)
unnamed: C42.1, R44.1, U8.7 (ISET)
unnamed: C43.2, L7.1, U8.3 (SW)
unnamed: C46.1, U9.5 (BIAS)
unnamed: C45.1, R46.1, U9.7 (ISET)
unnamed: C46.2, L8.1, U9.3 (SW)
unnamed: C49.1, U10.5 (BIAS)
unnamed: C48.1, R48.1, U10.7 (ISET)
unnamed: C49.2, L9.1, U10.3 (SW)

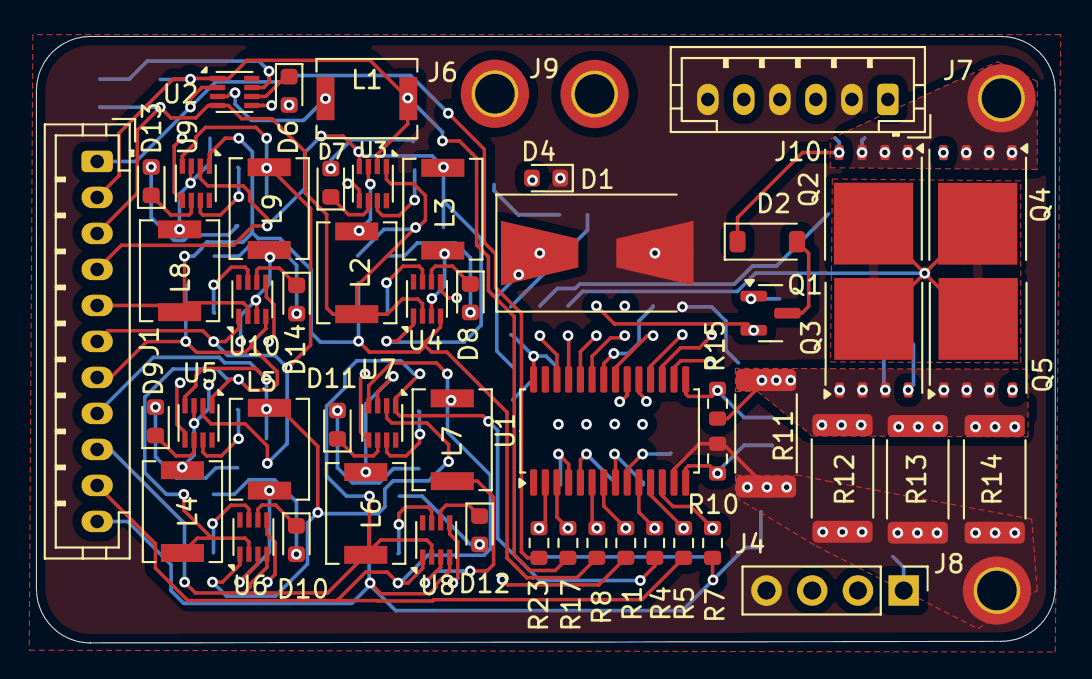
[picture p63: board battery.kicad_pcb from above]

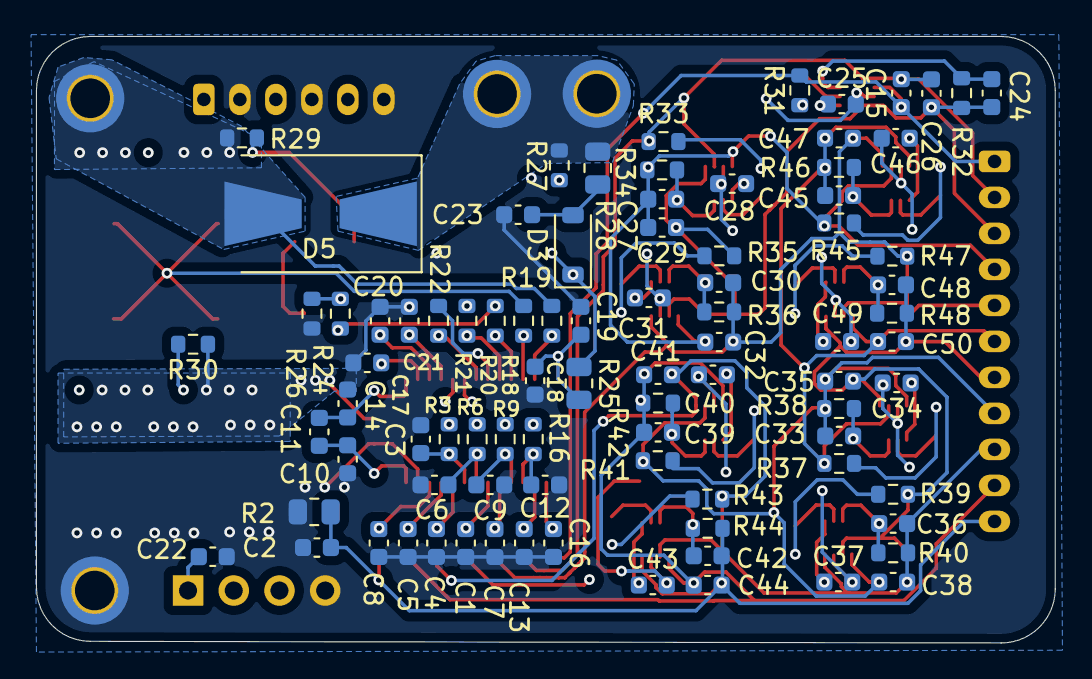
[picture p64: board battery.kicad_pcb from below]

Board: 6 copper layers, 56.6 x 33.7 mm, 143 parts (87 on the bottom side), 94 nets.
