86kkd/millionBoard/pcb/foc/foc.kicad_pcb

## KiCad design pcb/foc/foc.kicad_pcb (2025-03-11)

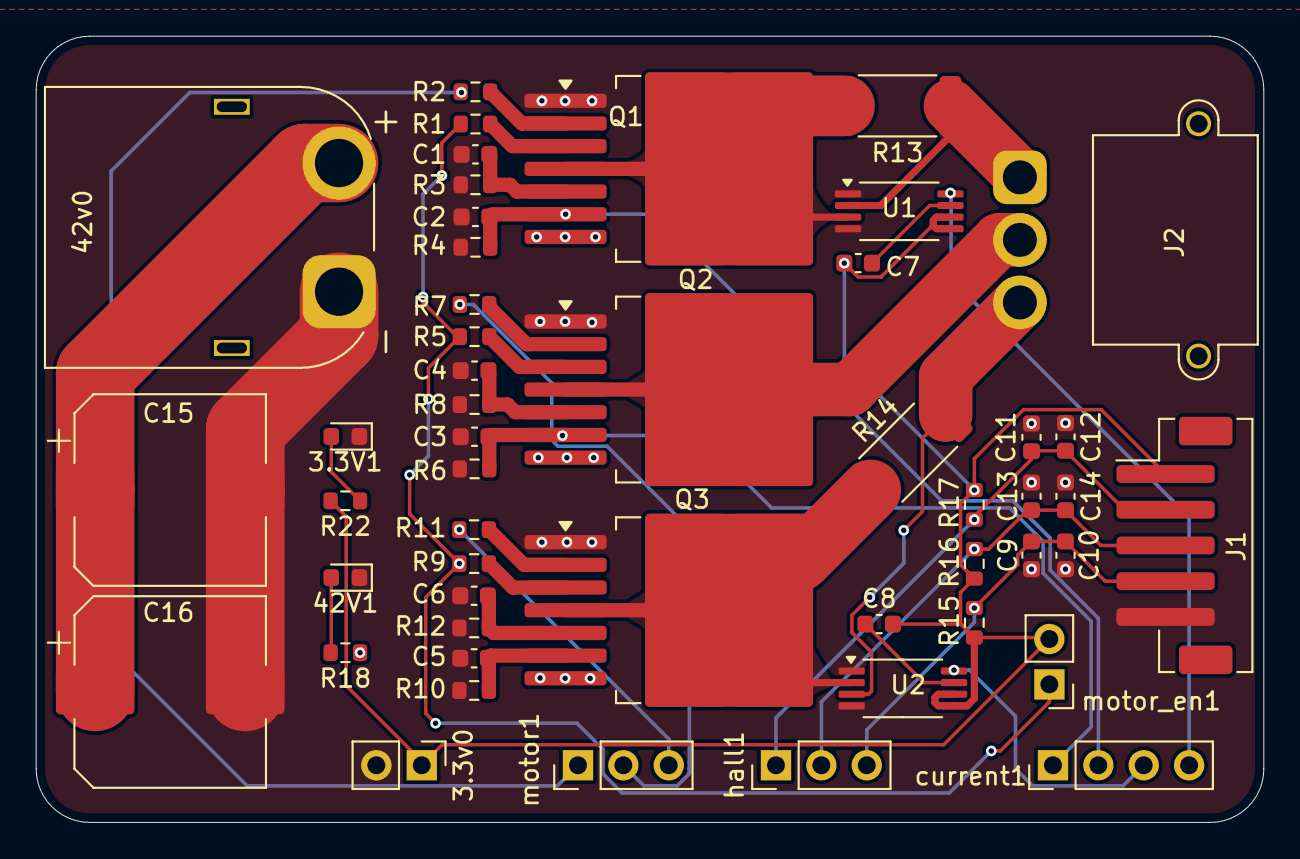
[picture p65: board foc.kicad_pcb from above]

Board: 2 copper layers, 68.7 x 44.0 mm, 50 parts (0 on the bottom side), 33 nets.

Parts:
3.3V1, 42V1: LED; LED_0603_1608Metric
3.3v0: Power3.3; PinHeader_1x02_P2.54mm_Vertical
42v0: Power42V; AMASS_XT60PW-M_1x02_P7.20mm_Horizontal
C1, C4, C6, C9, C11, C13: 100nF; C_0603_1608Metric
C2, C3, C5: 1nF; C_0603_1608Metric
C7, C8: 0.1nF; C_0603_1608Metric
C10, C12, C14: 20pF; C_0603_1608Metric
C15, C16: 330uf; CP_Elec_10x10.5
J1: PH_2.0; JST_PH_B5B-PH-SM4-TB_1x05-1MP_P2.00mm_Vertical
J2: TB_MOTOR; AMASS_MR30PW-M_1x03_P3.50mm_Horizontal
Q1, Q2, Q3: BTN8982TA; TO-263-7_TabPin8
R1, R2, R5, R7, R9, R11, R18: 10k; R_0603_1608Metric
R3, R8, R12: 0.51k; R_0603_1608Metric
R4, R6, R10, R22: 1k; R_0603_1608Metric
R13, R14: 0.001; R_2512_6332Metric
R15, R16, R17: 3.3k; R_0603_1608Metric
U1, U2: INA240A2PW; TSSOP-8_4.4x3mm_P0.65mm
current1: current info; PinHeader_1x04_P2.54mm_Vertical
hall1: sig; PinHeader_1x03_P2.54mm_Vertical
motor1: input; PinHeader_1x03_P2.54mm_Vertical
motor_en1: en_sig; PinHeader_1x02_P2.54mm_Vertical

Connections:
+3.3V: 3.3v0.1, C7.2, C8.2, J1.1, R15.2, R16.2, R17.1, R22.2, U1.5 (V+), U1.6 (REF2), U2.5 (V+), U2.6 (REF2), motor_en1.2
A0: U1.8, current1.4
A1: U2.8, current1.3
A2: C2.1, Q1.6 (IS), R4.1, current1.2
A3: C3.1, Q2.6 (IS), R6.1, current1.1
GND: 3.3V1.1 (K), 3.3v0.2, 42V1.1 (K), 42v0.1, C1.2, C2.2, C3.2, C4.2, C5.2, C6.2, C9.2, C10.1, C11.2, C12.1, C13.2, C14.1, C15.2, C16.2, J1.5, Q1.1, Q2.1, Q3.1, R3.2, R4.2, R6.2, R8.2, R10.2, R12.2, U1.1 (GND), U1.4 (GND), U2.1 (GND), U2.4 (GND)
INH_EN: R1.2, R5.2, R9.2, motor_en1.1
IN_1: R2.2, motor1.1
IN_2: R7.2, motor1.2
IN_3: R11.2, motor1.3
MOT_A: C11.1, C12.2, J1.2, R17.2, hall1.1
MOT_B: C13.1, C14.2, J1.3, R16.1, hall1.2
MOT_C: C9.1, C10.2, J1.4, R15.1, hall1.3
unnamed: 3.3V1.2 (A), R22.1
unnamed: 42V1.2 (A), R18.2
unnamed: Q1.2 (IN), R2.1
unnamed: Q1.3 (INH), R1.1
unnamed: C1.1, Q1.5 (SR), R3.1
unnamed: Q2.2 (IN), R7.1
unnamed: Q2.3 (INH), R5.1
unnamed: C4.1, Q2.5 (SR), R8.1
unnamed: Q3.2 (IN), R11.1
unnamed: Q3.3 (INH), R9.1
unnamed: C5.1, Q3.6 (IS), R10.1
unnamed: C6.1, Q3.5 (SR), R12.1
unnamed: C7.1, U1.7 (REF1)
unnamed: C8.1, U2.7 (REF1)
VCC: 42v0.2, C15.1, C16.1, Q1.7, Q2.7, Q3.7, R18.1
out1: J2.1, R13.1, U1.2 (+)
out1_cs: Q1.4, Q1.8, R13.2, U1.3 (-)
out2: J2.2, Q2.4, Q2.8
out3: J2.3, R14.2, U2.3 (-)
out3_cs: Q3.4, Q3.8, R14.1, U2.2 (+)
