86kkd/millionBoard/pcb/sensor/sensor.kicad_pcb

## KiCad design pcb/sensor/sensor.kicad_pcb (2025-03-08)

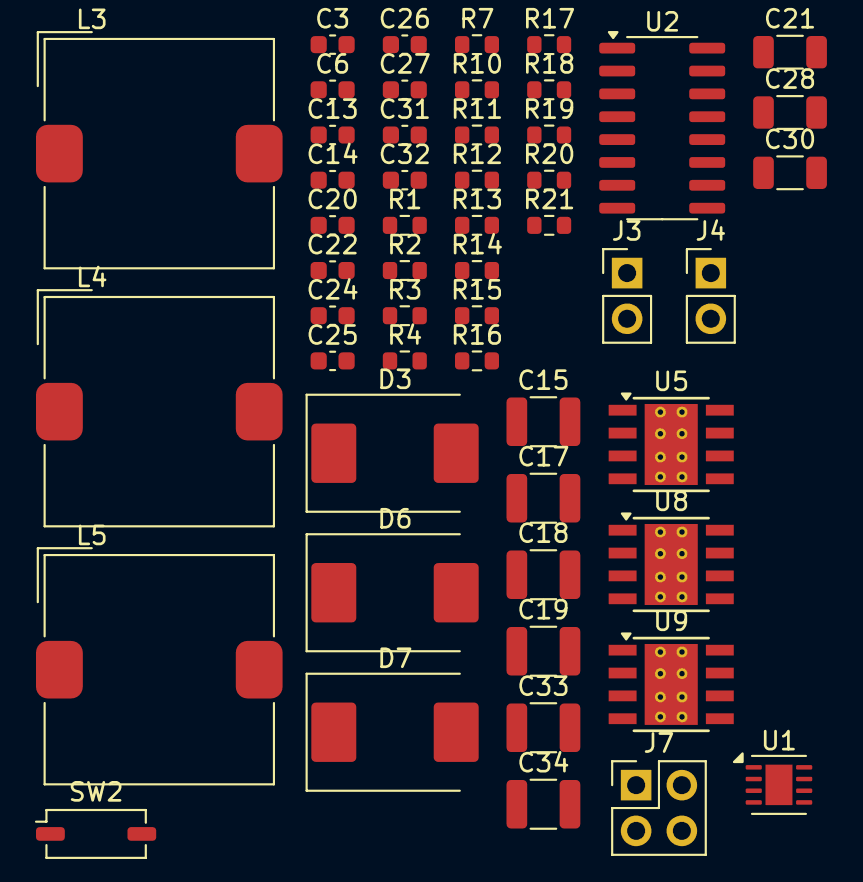
[picture p66: board sensor.kicad_pcb from above]

Board: 2 copper layers, 53 parts (0 on the bottom side), 36 nets, no tracks yet.

Parts:
C3: 0.1uF; C_0603_1608Metric
C6: 10uF; C_0603_1608Metric
C13, C25, C32: 100nF/16v; C_0603_1608Metric
C14: 68nF; C_0603_1608Metric
C15, C17: 10uF/35v; C_1210_3225Metric
C18, C19: 10uf/50v; C_1210_3225Metric
C20, C22: 100nf/50v; C_0603_1608Metric
C21, C28, C30: 4.7uf/50v; C_1206_3216Metric
C24, C31: 47nF; C_0603_1608Metric
C26, C27: 10uF/10v; C_0603_1608Metric
C33, C34: 10uF/16v; C_1210_3225Metric
D3, D6, D7: B560C; D_SMC
J3: sig_in; PinHeader_1x02_P2.54mm_Vertical
J4: sig_out; PinHeader_1x02_P2.54mm_Vertical
J7: Conn_02x02_Counter_Clockwise; PinHeader_2x02_P2.54mm_Vertical
L3, L4: 22uH; L_TDK_SLF12565
L5: 47uH; L_TDK_SLF12565
R1: 300k; R_0603_1608Metric
R2, R3: 100; R_0603_1608Metric
R4, R10, R14, R18: 10k; R_0603_1608Metric
R7: 100k; R_0603_1608Metric
R11, R15: 62k; R_0603_1608Metric
R12: 33k; R_0603_1608Metric
R13: 1k; R_0603_1608Metric
R16: 56k; R_0603_1608Metric
R17: 680; R_0603_1608Metric
R19, R20: 1.3k; R_0603_1608Metric
R21: 120; R_0603_1608Metric
SW2: SW_SPST; SW_DIP_SPSTx01_Slide_Copal_CHS-01A_W5.08mm_P1.27mm_JPin
U1: SIT1042AQT/3; DFN-8-1EP_3x3mm_P0.65mm_EP1.5x2.25mm
U2: HX711; SOP-16_3.9x9.9mm_P1.27mm
U5, U8, U9: LMR16030SDDAR; TI_SO-PowerPAD-8_ThermalVias

Connections:
3.3V/3A: C25.1, C26.1, C27.2, L4.2, R12.1
5V/3A: C32.1, C33.1, C34.2, L5.2, R16.1
24V/3A: C13.1, C15.1, C17.2, C21.2, C22.1, C28.1, C30.2, L3.2, R1.1, U8.2 (VIN), U9.2 (VIN)
+3.3V: C6.2, J7.1, U1.5 (VIO), U2.15 (RATE), U2.16 (DVDD)
+5V: J7.2, U1.3 (VCC), U2.1 (VSUP), U2.3 (AVDD)
CANH: SW2.2 (B), U1.7 (CANH)
CANL: R21.2, U1.6 (CANL)
DOUT: J4.1, U2.12 (DOUT)
GND: C6.1, C14.2, C15.2, C17.1, C18.2, C19.1, C20.2, C21.1, C22.2, C24.2, C26.2, C27.1, C28.2, C30.1, C31.2, C33.2, C34.1, D3.2 (A), D6.2 (A), D7.2 (A), J7.3, J7.4, R4.2, R7.2, R14.2, R18.2, R19.2, R20.2, U1.2 (GND), U1.8 (STB), U2.4 (VFB), U2.5 (AGND), U2.14 (XI), U5.7 (GND), U5.9 (EP), U8.7 (GND), U8.9 (EP), U9.7 (GND), U9.9 (EP)
INA+: J3.2, R2.2
INA-: J3.1, R3.2
unnamed: D3.1 (K), L3.1, U5.8 (SW)
unnamed: D6.1 (K), L4.1, U8.8 (SW)
unnamed: D7.1 (K), L5.1, U9.8 (SW)
unnamed: R1.2, R10.1
unnamed: R11.2, R19.1
unnamed: R12.2, R13.1
unnamed: R15.2, R20.1
unnamed: R16.2, R17.1
unnamed: R21.1, SW2.1 (A)
unnamed: C3.1, R2.1, U2.8 (INA+)
unnamed: C3.2, R3.1, U2.7 (INA-)
unnamed: C13.2, U5.1 (BOOT)
unnamed: R4.1, R10.2, U5.5 (FB)
unnamed: R7.1, U5.4 (RT/YNC)
unnamed: C14.1, U5.6 (SS/PGOOD)
unnamed: C25.2, U8.1 (BOOT)
unnamed: R13.2, R14.1, U8.5 (FB)
unnamed: R11.1, U8.4 (RT/YNC)
unnamed: C24.1, U8.6 (SS/PGOOD)
unnamed: C32.2, U9.1 (BOOT)
unnamed: R17.2, R18.1, U9.5 (FB)
unnamed: R15.1, U9.4 (RT/YNC)
unnamed: C31.1, U9.6 (SS/PGOOD)
PD_SCK: J4.2, U2.11 (PD_SCK)
VIN_MAX60V: C18.1, C19.2, C20.1, U5.2 (VIN)
