86kkd/millionBoard/src/skateboard_foc_project/components/pressure_sensor/src/pressure_sensor.cpp

#include "pressure_sensor.hpp"
#include "esp_err.h"
#include "esp_log.h"
#include "freertos/task.h"
#include "nvs.h"
#include "nvs_flash.h"
#include "sdkconfig.h"
#include <math.h>
#include <string>

static const char *TAG = "PressureSensor";

// Global HX711 and PressureSensor instances
static HX711 *g_hx711_front = nullptr;
static HX711 *g_hx711_rear = nullptr;
static PressureSensor *g_pressure_sensor_front = nullptr;
static PressureSensor *g_pressure_sensor_rear = nullptr;
static TaskHandle_t g_pressure_task_handle = nullptr;

// Initialize static data callback pointer
PressureSensor::DataCallback PressureSensor::data_callback_ = nullptr;

#define PS_EWMA_ALPHA 0.5f  // 指数平均系数

esp_err_t PressureSensor::Init(void) {
  // Allow HX711 modules to power up and stabilize
  vTaskDelay(pdMS_TO_TICKS(100));
  // Initialize HX711 sensors
  ESP_LOGI(TAG, "Initializing HX711 sensors...");

  // Create HX711 instances
  g_hx711_front =
      new HX711(static_cast<gpio_num_t>(CONFIG_HX711_FRONT_SCK_GPIO),
                static_cast<gpio_num_t>(CONFIG_HX711_FRONT_DOUT_GPIO),
                HX711::Mode::kChannelA128);

  g_hx711_rear = new HX711(static_cast<gpio_num_t>(CONFIG_HX711_REAR_SCK_GPIO),
                           static_cast<gpio_num_t>(CONFIG_HX711_REAR_DOUT_GPIO),
                           HX711::Mode::kChannelA128);

  // Create PressureSensor objects
  ESP_LOGI(TAG, "Creating pressure sensor interfaces...");
  g_pressure_sensor_front = new PressureSensor(*g_hx711_front);
  g_pressure_sensor_rear = new PressureSensor(*g_hx711_rear);

  // Load calibration from NVS
  bool front_loaded = g_pressure_sensor_front->LoadCalibration(
      CONFIG_HX711_NVS_NAMESPACE, CONFIG_HX711_NVS_KEY_PREFIX_FRONT);
  bool rear_loaded = g_pressure_sensor_rear->LoadCalibration(
      CONFIG_HX711_NVS_NAMESPACE, CONFIG_HX711_NVS_KEY_PREFIX_REAR);

  // Report pressure sensor status
  ESP_LOGI(TAG, "Front pressure sensor: %s, offset=%.2f, scale=%.2f",
           front_loaded ? "calibrated" : "not calibrated",
           g_pressure_sensor_front->GetOffset(),
           g_pressure_sensor_front->GetScale());

  ESP_LOGI(TAG, "Rear pressure sensor: %s, offset=%.2f, scale=%.2f",
           rear_loaded ? "calibrated" : "not calibrated",
           g_pressure_sensor_rear->GetOffset(),
           g_pressure_sensor_rear->GetScale());

  // Create task to read pressure sensors
  xTaskCreate(PressureSensor::Task, "pressure_sensor", 4096, NULL, 5,
              &g_pressure_task_handle);

  return ESP_OK;
}

esp_err_t PressureSensor::Deinit(void) {
  // Delete task if it exists
  if (g_pressure_task_handle != nullptr) {
    vTaskDelete(g_pressure_task_handle);
    g_pressure_task_handle = nullptr;
  }

  // Clean up sensor objects
  if (g_pressure_sensor_front != nullptr) {
    delete g_pressure_sensor_front;
    g_pressure_sensor_front = nullptr;
  }

  if (g_pressure_sensor_rear != nullptr) {
    delete g_pressure_sensor_rear;
    g_pressure_sensor_rear = nullptr;
  }

  if (g_hx711_front != nullptr) {
    delete g_hx711_front;
    g_hx711_front = nullptr;
  }

  if (g_hx711_rear != nullptr) {
    delete g_hx711_rear;
    g_hx711_rear = nullptr;
  }

  return ESP_OK;
}

void PressureSensor::Task(void *pvParameters) {
  if (!g_pressure_sensor_front || !g_pressure_sensor_rear) {
    ESP_LOGE(TAG, "Pressure sensors not initialized!");
    vTaskDelete(NULL);
    return;
  }

  // Shared data structure
  float front_pressure = 0.0f;
  float rear_pressure = 0.0f;
  float target_speed = 0.0f;
  bool is_moving = false;

  while (1) {
    // Read raw pressures and apply EWMA 滤波
    static bool ps_first = true;
    static float ps_filt_front = 0.0f, ps_filt_rear = 0.0f;
    float raw_front = g_pressure_sensor_front->GetWeight(5);
    float raw_rear = g_pressure_sensor_rear->GetWeight(5);
    if (ps_first) {
      ps_filt_front = raw_front;
      ps_filt_rear = raw_rear;
      ps_first = false;
    } else {
      ps_filt_front = PS_EWMA_ALPHA * raw_front + (1 - PS_EWMA_ALPHA) * ps_filt_front;
      ps_filt_rear = PS_EWMA_ALPHA * raw_rear + (1 - PS_EWMA_ALPHA) * ps_filt_rear;
    }
    front_pressure = ps_filt_front;
    rear_pressure = ps_filt_rear;

    // Calculate center of gravity and target speed
    float weight_diff = front_pressure - rear_pressure;
    float total_weight = front_pressure + rear_pressure;

    if (total_weight > 30000.0f) { // Confirm someone is on the board
      // Calculate balance point percentage (-1.0 to 1.0) as normalized speed
      float balance_point = weight_diff / total_weight;
      if (fabs(balance_point) < 0.3f) balance_point = 0.0f;
      target_speed = balance_point;  // normalized target speed [-1,1]
      is_moving = (fabs(balance_point) > 0.05f);
    } else {
      // No one on the board, stop
      target_speed = 0.0f;
      is_moving = false;
    }

    // ESP_LOGI(TAG,
    //          "Pressure - Front: %.1f, Rear: %.1f, Target Speed: %.1f ,front "
    //          "weight: %.1f, rear weight: %.1f, total weight: %.1f",
    //          front_pressure, rear_pressure, target_speed, front_pressure,
    //          rear_pressure, total_weight);

    // Report data via callback if registered
    if (data_callback_) {
      data_callback_(front_pressure, rear_pressure, target_speed, is_moving);
    }

    vTaskDelay(pdMS_TO_TICKS(50)); // 20Hz sampling rate
  }
}

PressureSensor::PressureSensor(HX711 &hx711)
    : hx711_(hx711), offset_(0.0f), scale_factor_(1.0f) {}

bool PressureSensor::Tare(int samples, TickType_t timeout) {
  int32_t zero_point = ReadAverage(samples, timeout);
  if (zero_point == 0) {
    return false;
  }

  offset_ = zero_point;
  ESP_LOGI(TAG, "Zero point calibration successful. Offset: %.2f", offset_);
  return true;
}

bool PressureSensor::Calibrate(float known_weight, int samples,
                               TickType_t timeout) {
  if (known_weight <= 0) {
    ESP_LOGE(TAG, "Known weight must be greater than zero for calibration");
    return false;
  }

  int32_t measured_value = ReadAverage(samples, timeout);
  if (measured_value == 0) {
    return false;
  }

  float scale = (measured_value - offset_) / known_weight;
  if (scale == 0) {
    ESP_LOGE(TAG, "Calibration error: scale factor is zero");
    return false;
  }

  scale_factor_ = scale;
  ESP_LOGI(TAG, "Calibration successful. Scale factor: %.2f", scale_factor_);
  return true;
}

float PressureSensor::GetWeight(int samples, TickType_t timeout) {
  int32_t value = ReadAverage(samples, timeout);
  // Only treat undefined readings (timeout) as invalid
  if (value == HX711::kUndefined) {
    return NAN;
  }
  return (value - offset_) / scale_factor_;
}

bool PressureSensor::SaveCalibration(const char *namespace_name,
                                     const char *key_prefix) {
  if (namespace_name == nullptr || key_prefix == nullptr) {
    ESP_LOGE(TAG, "Invalid namespace or key prefix");
    return false;
  }

  nvs_handle_t nvs_handle;
  esp_err_t err = nvs_open(namespace_name, NVS_READWRITE, &nvs_handle);
  if (err != ESP_OK) {
    ESP_LOGE(TAG, "Failed to open NVS namespace: %s", esp_err_to_name(err));
    return false;
  }

  char offset_key[64];
  char scale_key[64];

  snprintf(offset_key, sizeof(offset_key), "%s_offset", key_prefix);
  snprintf(scale_key, sizeof(scale_key), "%s_scale", key_prefix);

  // Save offset as blob
  err = nvs_set_blob(nvs_handle, offset_key, &offset_, sizeof(float));
  if (err != ESP_OK) {
    ESP_LOGE(TAG, "Failed to save offset: %s", esp_err_to_name(err));
    nvs_close(nvs_handle);
    return false;
  }

  // Save scale factor as blob
  err = nvs_set_blob(nvs_handle, scale_key, &scale_factor_, sizeof(float));
  if (err != ESP_OK) {
    ESP_LOGE(TAG, "Failed to save scale factor: %s", esp_err_to_name(err));
    nvs_close(nvs_handle);
    return false;
  }

  err = nvs_commit(nvs_handle);
  if (err != ESP_OK) {
    ESP_LOGE(TAG, "Failed to commit NVS data: %s", esp_err_to_name(err));
    nvs_close(nvs_handle);
    return false;
  }

  nvs_close(nvs_handle);
  ESP_LOGI(TAG, "Calibration data saved to NVS");
  return true;
}

bool PressureSensor::LoadCalibration(const char *namespace_name,
                                     const char *key_prefix) {
  if (namespace_name == nullptr || key_prefix == nullptr) {
    ESP_LOGE(TAG, "Invalid namespace or key prefix");
    return false;
  }

  nvs_handle_t nvs_handle;
  esp_err_t err = nvs_open(namespace_name, NVS_READONLY, &nvs_handle);
  if (err != ESP_OK) {
    ESP_LOGE(TAG, "Failed to open NVS namespace: %s", esp_err_to_name(err));
    return false;
  }

  char offset_key[64];
  char scale_key[64];

  snprintf(offset_key, sizeof(offset_key), "%s_offset", key_prefix);
  snprintf(scale_key, sizeof(scale_key), "%s_scale", key_prefix);

  float offset = 0.0f;
  float scale = 0.0f;
  bool success = true;
  size_t size = sizeof(float);

  // Read offset as blob
  err = nvs_get_blob(nvs_handle, offset_key, &offset, &size);
  if (err != ESP_OK || size != sizeof(float)) {
    ESP_LOGW(TAG, "Failed to read offset: %s, checking legacy format",
             esp_err_to_name(err));
    if (!LoadLegacyCalibration(nvs_handle, key_prefix)) {
      success = false;
    }
  } else {
    // Read scale factor as blob
    size = sizeof(float);
    err = nvs_get_blob(nvs_handle, scale_key, &scale, &size);
    if (err != ESP_OK || size != sizeof(float)) {
      ESP_LOGE(TAG, "Failed to read scale factor: %s", esp_err_to_name(err));
      success = false;
    } else {
      // Successfully read both values
      offset_ = offset;
      scale_factor_ = scale;
      ESP_LOGI(TAG, "Loaded calibration - Offset: %.2f, Scale factor: %.2f",
               offset_, scale_factor_);
    }
  }

  nvs_close(nvs_handle);
  return success;
}

bool PressureSensor::LoadLegacyCalibration(nvs_handle_t nvs_handle,
                                           const char *key_prefix) {
  ESP_LOGI(TAG, "Attempting to load legacy calibration format");

  char legacy_key[64];
  snprintf(legacy_key, sizeof(legacy_key), "%s_cal", key_prefix);

  size_t required_size = 0;

  // Check if legacy calibration data exists
  esp_err_t err = nvs_get_blob(nvs_handle, legacy_key, nullptr, &required_size);
  if (err != ESP_OK || required_size != 2 * sizeof(float)) {
    ESP_LOGE(TAG, "Legacy calibration data not found or invalid");
    return false;
  }

  // Load legacy data
  float cal_data[2];
  err = nvs_get_blob(nvs_handle, legacy_key, cal_data, &required_size);
  if (err != ESP_OK) {
    ESP_LOGE(TAG, "Failed to load legacy calibration data: %s",
             esp_err_to_name(err));
    return false;
  }

  offset_ = cal_data[0];
  scale_factor_ = cal_data[1];

  ESP_LOGI(TAG, "Loaded legacy calibration - Offset: %.2f, Scale factor: %.2f",
           offset_, scale_factor_);

  // Migrate legacy data to new format (in a separate function call to
  // SaveCalibration)
  ESP_LOGI(TAG, "Migrating legacy calibration data to new format");

  return true;
}

int32_t PressureSensor::ReadAverage(int samples, TickType_t timeout) {
  int64_t sum = 0;
  int valid_samples = 0;

  for (int i = 0; i < samples; i++) {
    int32_t value = hx711_.Read(timeout);
    // Discard undefined samples
    if (value != HX711::kUndefined) {
      sum += value;
      valid_samples++;
    }
  }

  if (valid_samples == 0) {
    ESP_LOGE(TAG, "No valid samples read from HX711");
    return 0;
  }

  return static_cast<int32_t>(sum / valid_samples);
}

void PressureSensor::SetCalibration(float offset, float scale_factor) {
  offset_ = offset;
  scale_factor_ = scale_factor;
}

// Add callback registration implementation
void PressureSensor::RegisterCallback(DataCallback cb) { data_callback_ = cb; }
