86kkd/millionBoard/src/skateboard_foc_project/components/current_sensor/include/current_sensor.hpp

#ifndef INLINE_CS_LIB_H
#define INLINE_CS_LIB_H

#include "base_classes/CurrentSense.h"
#include "esp_adc/adc_oneshot.h" // for adc_oneshot_unit_handle_t

class ESP32InlineCurrentSense : public CurrentSense {
public:
  /**
    InlineCurrentSense class constructor
    @param shunt_resistor shunt resistor value
    @param gain current-sense op-amp gain
    @param phA A phase adc pin
    @param phB B phase adc pin
    @param phC C phase adc pin (optional)
  */
  ESP32InlineCurrentSense(float shunt_resistor, float gain, int pinA, int pinB,
                          int pinC = NOT_SET);
  /**
    InlineCurrentSense class constructor
    @param mVpA mV per Amp ratio
    @param phA A phase adc pin
    @param phB B phase adc pin
    @param phC C phase adc pin (optional)
  */
  ESP32InlineCurrentSense(float mVpA, int pinA, int pinB, int pinC = NOT_SET);

  // CurrentSense interface implementing functions
  int init() override;
  PhaseCurrent_s getPhaseCurrents() override;
  int driverAlign(float align_voltage) override;

  // ADC measuremnet gain for each phase
  // support for different gains for different phases of more commonly -
  // inverted phase currents this should be automated later
  float gain_a; //!< phase A gain
  float gain_b; //!< phase B gain
  float gain_c; //!< phase C gain

  // // per phase low pass fileters
  // LowPassFilter lpf_a{DEF_LPF_PER_PHASE_CURRENT_SENSE_Tf}; //!<  current A
  // low pass filter LowPassFilter lpf_b{DEF_LPF_PER_PHASE_CURRENT_SENSE_Tf};
  // //!<  current B low pass filter LowPassFilter
  // lpf_c{DEF_LPF_PER_PHASE_CURRENT_SENSE_Tf}; //!<  current C low pass filter

  float offset_ia; //!< zero current A voltage value (center of the adc reading)
  float offset_ib; //!< zero current B voltage value (center of the adc reading)
  float offset_ic; //!< zero current C voltage value (center of the adc reading)

private:
  // hardware variables
  int pinA; //!< pin A analog pin for current measurement
  int pinB; //!< pin B analog pin for current measurement
  int pinC; //!< pin C analog pin for current measurement

  // gain variables
  float shunt_resistor;      //!< Shunt resistor value
  float amp_gain;            //!< amp gain value
  float volts_to_amps_ratio; //!< Volts to amps ratio

  /**
   *  Function finding zero offsets of the ADC
   */
  void calibrateOffsets();
};

#ifdef __cplusplus
extern "C" {
#endif

// Provide the ADC handle used by the shared ADC unit
void current_sensor_set_adc_handle(adc_oneshot_unit_handle_t handle);

#ifdef __cplusplus
}
#endif

#endif
