86kkd/millionBoard/src/skateboard_foc_project/components/olcd/include/olcd.h

#include "esp_lvgl_port.h"
#include "lvgl.h"
#ifdef __cplusplus
extern "C" {
#endif
typedef struct _olcd_data {
  lv_disp_t *disp;
  float *data;
} olcd_data;
lv_disp_t *setup_olcd(void);
void run_olcd(void *);
#ifdef __cplusplus
}
#endif
