86kkd/millionBoard/(commit log)

2024-11-24 restruce project
    [GPS_Audio.kicad_sch, ad_trans.kicad_sch, battery_protect.kicad_sch, dc-dc.kicad_sch, main_ctrl.kicad_sch, motor_drive.kicad_sch, skateboard.kicad_pcb, skateboard.kicad_sch]
2024-12-04 foc subBoard design
    [foc.kicad_pcb, foc.kicad_sch]
2024-12-04 update foc board
    [foc.kicad_pcb, foc.kicad_sch]
2024-12-04 foc debug info designe
    [foc.kicad_pcb, foc.kicad_sch]
2024-12-05 assign foot prints
    [foc.kicad_pcb, foc.kicad_sch]
2024-12-10 更新原理图和pcb
    [foc.kicad_pcb, foc.kicad_sch]
2024-12-17 focV3 update
    [foc.kicad_pcb, foc.kicad_sch]
2024-12-23 dc-dc 原理图
    [dc-dc.kicad_pcb, dc-dc.kicad_sch]
2024-12-24 update dc-dc
    [dc-dc.kicad_sch]
2024-12-24 update pcb
    [foc.kicad_pcb, foc.kicad_sch]
2024-12-24 update foc pcb
    [foc.kicad_pcb]
2024-12-24 update sensor
    [sensor.kicad_pcb, sensor.kicad_sch]
2025-01-09 更新kiacad sensor的原理图
    [sensor.kicad_sch]
2025-01-31 最简实现-faile
2025-02-25 feat: update sensor pcb
    [sensor.kicad_pcb, sensor.kicad_sch]
2025-03-03 feat: update dc-dc
    [sensor.kicad_pcb, sensor.kicad_sch]
2025-03-03 feat: update foc
    [foc.kicad_pcb]
2025-03-04 feat: add dc-dc compute script
    [sensor.kicad_sch]
2025-03-04 feat: update sch adn scripts
    [sensor.kicad_sch]
2025-03-08 feat: update
    [GPS_Audio.kicad_sch, ad_trans.kicad_sch, battery_protect.kicad_sch, dc-dc.kicad_sch, main_ctrl.kicad_sch, motor_drive.kicad_sch, sensor.kicad_pcb, sensor.kicad_sch]
2025-03-11 feat: update pdf
    [CAN收发器模块与STM32开发板引脚连接说明.xlsx]
2025-04-09 feat: error config component
    [angle_sensor.c, angle_sensor.h, gps.c, gps.h, nfc.c, nfc.h]
2025-04-09 feat: fix enable component bug
    [angle_sensor.c, gps.c, nfc.c]
2025-04-09 feat: add double motor ctl
2025-04-09 feat: fix motor enale pin
2025-04-10 feat: add current sensor for motor
2025-04-20 feat: add pressure_sensor implement
2025-05-01 feat: add new dc-dc
    [new_dc-dc.kicad_pcb, new_dc-dc.kicad_sch]
2025-05-02 feat: new_dc-dc pcb
    [new_dc-dc-B_Cu.gbr, new_dc-dc-B_Mask.gbr, new_dc-dc-B_Paste.gbr, new_dc-dc-B_Silkscreen.gbr, new_dc-dc-Edge_Cuts.gbr, new_dc-dc-F_Cu.gbr, new_dc-dc-F_Mask.gbr, new_dc-dc-F_Paste.gbr]
2025-05-02 fix: make eable component logic applay for all xtask
    [motor_control_foc.cpp, motor_control_foc.hpp]
2025-05-02 feat: udpate pcb
    [dc-dc.kicad_sch]
2025-05-02 refactor: internal pressure_sensor init logic
2025-05-02 chore: update kicad_sch
    [dc-dc.kicad_sch, foc.kicad_sch, mcu.kicad_sch, sensor.kicad_sch, skateboard.kicad_sch]
2025-05-02 chore: update foc ctrl pin
2025-05-14 feat: update a lot
    [data.csv]
2025-05-20 feat: 实现olcd显示
